m47812/Custom-3D-Printer-Controller/3D_Printer_Mainboard_STM32/Komponenten_V2.xlsx

Qty | Reference | VALUE | MF | DESCRIPTION | Dist. | Order Nr. | Price | Total
1 | NHD-0420AZ-FSW-GBW-33V3 |  |  | LCD Display 3.3V 20x4 | Mouser | 763-0420AZFSWGBW33V3 | 20
1 | ATWINC1500-MR210PB1954 |  |  | Wlan Modul | Mouser | 579-1500MR210PB1954 | 7.62
 | O705012MHEA4SI |  |  | Oszilatzor 12MHz | LCSC | C70647
 | HUF76639S3ST |  |  | Heatbed N MOS | LCSC | C184262 (https://lcsc.com/product-detail/MOSFET_ON-Semicon_HUF76639S3ST_ON-Semicon-ON-HUF76639S3ST_C184262.html/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)
2 | AO3400A |  |  | Extruder N MOS | LCSC | C20917 (https://lcsc.com/product-detail/MOSFET_Changjiang-Electronics-Tech-CJ-2N7002_C8545.html/?href=jlc-SMT)
 | 2920L260/24DR |  |  | Extruder Heater PTC Fuse 2.6A/24V | LCSC | C315904 (https://lcsc.com/product-detail/PTC-Resettable-Fuses_Littelfuse-2920L260-24DR_C315904.html/?href=jlc-SMT)
 | ATMEGA328P-AU |  |  | 328p atmega temperatur controller |  | C14877 (https://lcsc.com/product-detail/ATMEL-AVR_ATMEL_ATMEGA328P-AU_ATMEGA328P-AU_C14877.html/?href=jlc-SMT)
 | EL357N(C)(TA)-G |  |  | Optokopler Power ON |  | C29981 (https://lcsc.com/product-detail/SMD-Optocouplers_EL357N-C-TA-G_C29981.html/?href=jlc-SMT)
 |  |  |  | ELKO 220uF |  | C134732 (https://lcsc.com/product-detail/Aluminum-Electrolytic-Capacitors-SMD_Lelon-VE-221M1HTR-1010_C134732.html/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)
 |  |  |  | 3er Screw Terminal 2.54 6A |  | 651-1725669
 |  |  |  | 4er Screw Terminal 2.54 6A Stepper |  | 651-1725672
 |  |  |  | Spule 6.8uH MWSA0618-6R8MT |  | C132134 (https://lcsc.com/product-detail/Power-Inductors_Sunlord-MWSA0618-6R8MT_C132134.html/?href=jlc-SMT)
 |  |  |  | Header 2x3 2.54 dimensionen Prüfen |  | 649-1012938190602BLF
 |  |  |  | Header 2x8 2.54 dimensionen Prüfen |  | 855-M20-9720846
 |  |  |  | USB Stecker |  | 710-629105150521
 |  |  |  | 2er Screw Terminal 9.52mm 32A |  | 651-1756993
 |  |  |  | Heatbed Connector |  | 651-1888807
 |  |  |  | SD Karten Halter |  | 798-DM3D-SF
 |  |  |  | 100mohm widerstände |  | C63324
 |  |  |  | 100mOhm alternative |  | 71-RCWE1210R100FKEA
 |  |  |  | 22kOhm Poti |  | 652-3296Y-1-223LF
 |  |  |  | Switch |  | C318888 (https://lcsc.com/product-detail/Tactile-Switches_XKB-Enterprise-TS-1187A-C-D-A_C318888.html/?href=jlc-SMT)
 | STM32F722RET6 |  |  | Cortex-M7 mit FPU und DMA 64Pin |  | C118207 (https://lcsc.com/product-detail/ST-Microelectronics_STMicroelectronics_STM32F722RET6_STM32F722RET6_C118207.html/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)
 | TMC2209 |  |  | New smaler Motor driver |  | C465949 (https://lcsc.com/product-detail/Motor-Drivers_TRINAMIC-Motion-Control-GmbH-TMC2209-LA_C465949.html/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)
 | SMAZ27-13-F |  |  | Lüfterschutzdiode |  | C155318 (https://lcsc.com/product-detail/Zener-Diodes_DIODES_SMAZ27-13-F_SMAZ27-13-F_C155318.html/?href=jlc-SMT)
 | 100uF
 | 220uf |  |  |  |  | C164065 (https://lcsc.com/product-detail/Aluminum-Electrolytic-Capacitors-SMD_Lelon-VEJ221M1VTR-0810_C164065.html/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)
 |  |  |  | Screw Terminal 6Pin |  | 651-1725698
 | B5819W |  |  | Diode Stall E1 E0 |  | C8598 (https://lcsc.com/product-detail/Schottky-Barrier-Diodes-SBD_Changjiang-Electronics-Tech-CJ-B5819W_C8598.html/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)
 |  |  |  | LED MUPI |  | 78-TLLG4400-AS12
 |  |  |  | Button Mupi |  | C318887 (https://lcsc.com/product-detail/Tactile-Switches_XKB-Enterprise-TS-1187A-C-E-A_C318887.html/?href=jlc-SMT)
 |  |  |  | Ersatz MOS Heatbead |  | C180966 (https://lcsc.com/product-detail/MOSFET_Shenzhen-ruichips-Semicon-RU30120S_C180966.html/?href=jlc-SMT)
 |  |  |  | Ersatz Induktor 6.8uH |  | C408348
 | 220uf |  |  | Ersatz elko |  | C134820
