m47812/Custom-3D-Printer-Controller/3D_Printer_Mainboard_STM32/3D_Printer_Mainboard_STM32.pdf

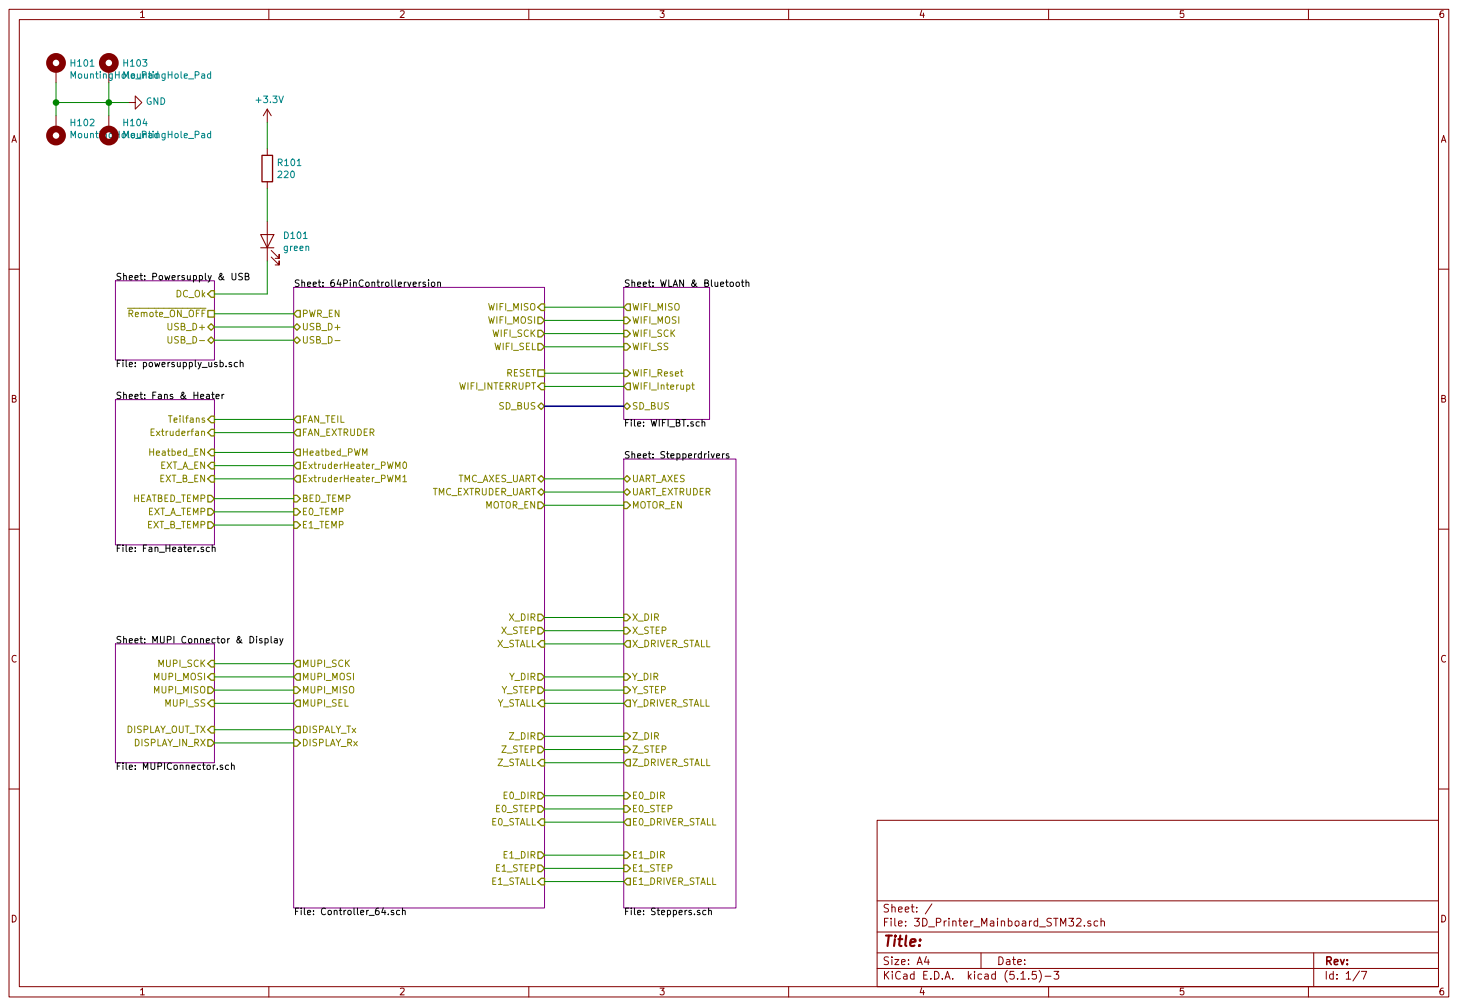
[picture p5: page 1]

Sheet: WLAN & Bluetooth File: WIFI_BT.sch WIFI_SS WIFI_MISO WIFI_SCK WIFI_Reset WIFI_Interupt WIFI_MOSI SD_BUS

Sheet: Fans & Heater File: Fan_Heater.sch Teilfans Extruderfan Heatbed_EN

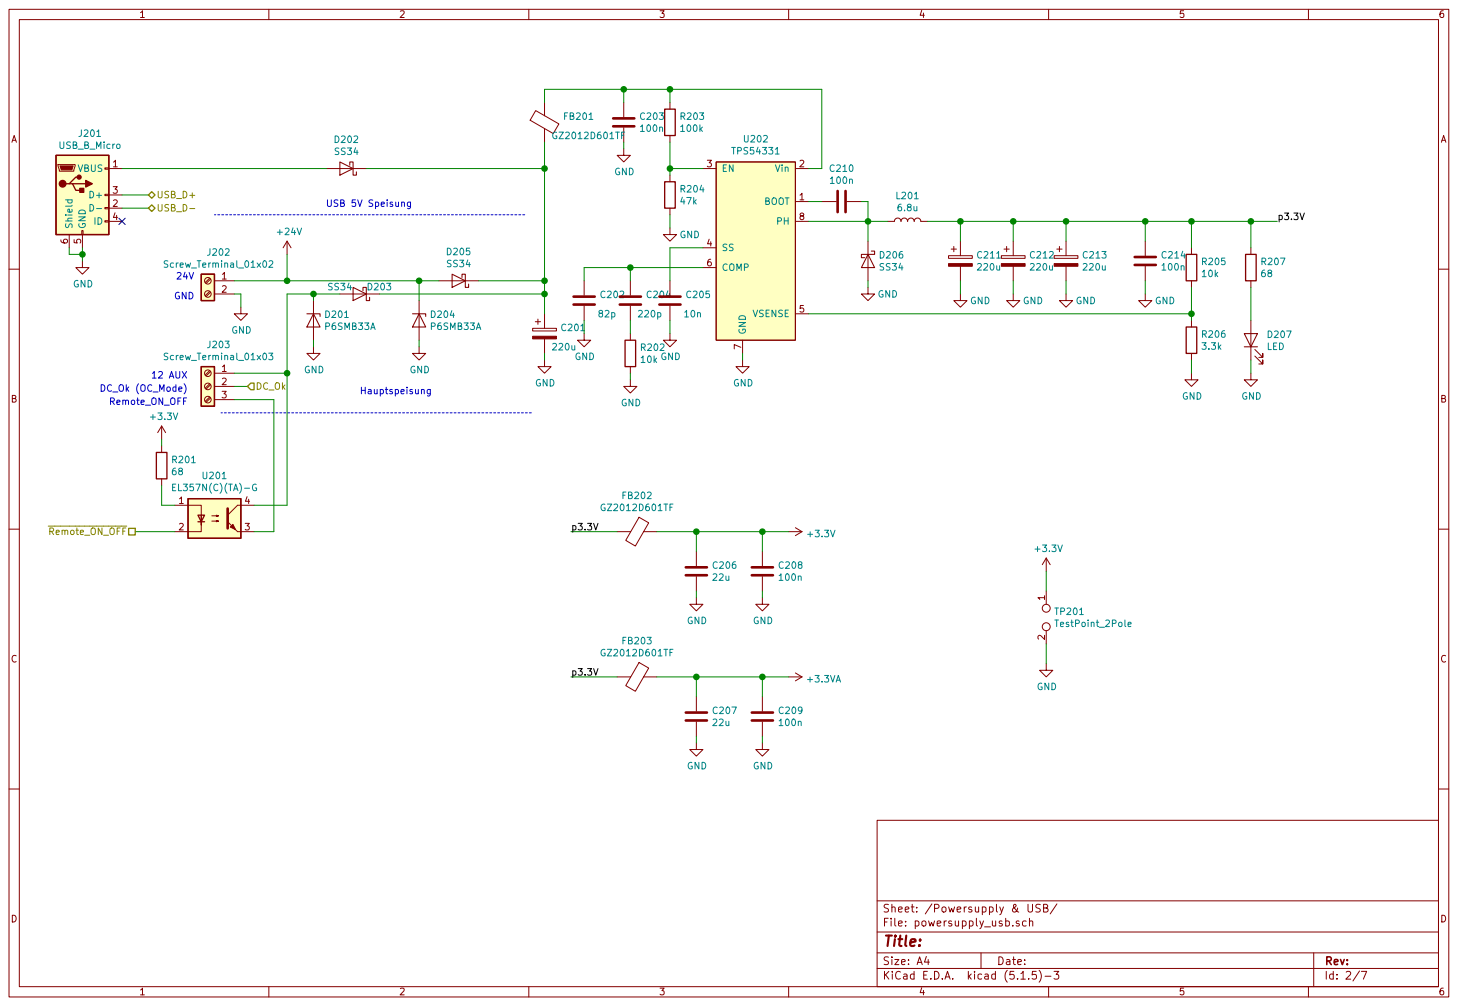
[picture p6: page 2]

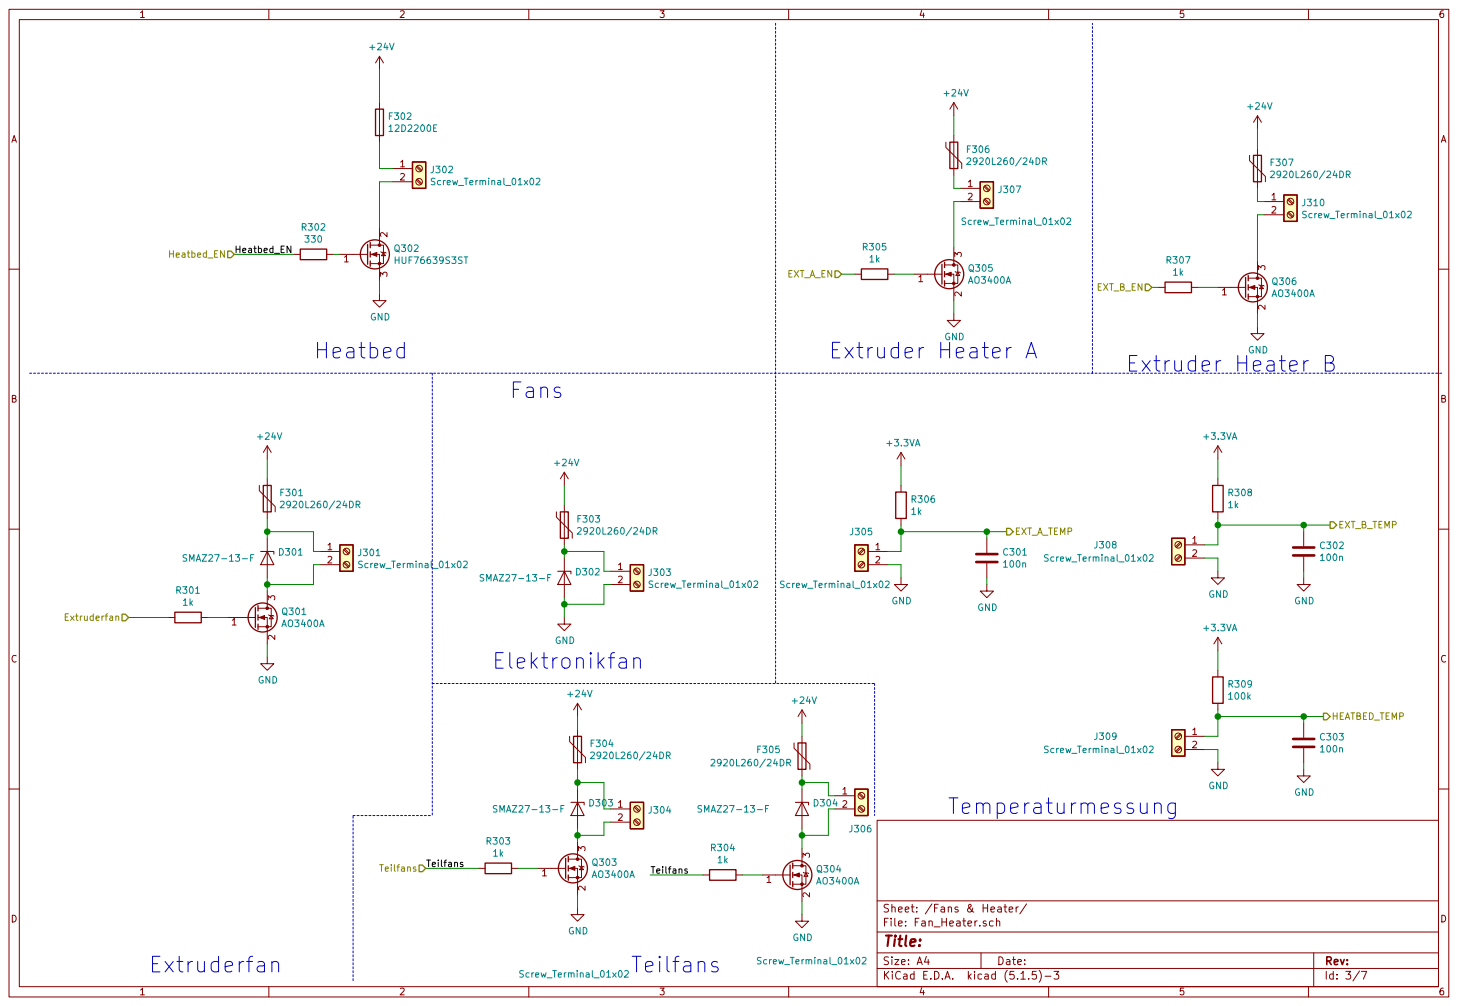
[picture p7: page 3]

File: Fan_Heater.sch Sheet: /Fans & Heater/
Id: 3/7 Title:

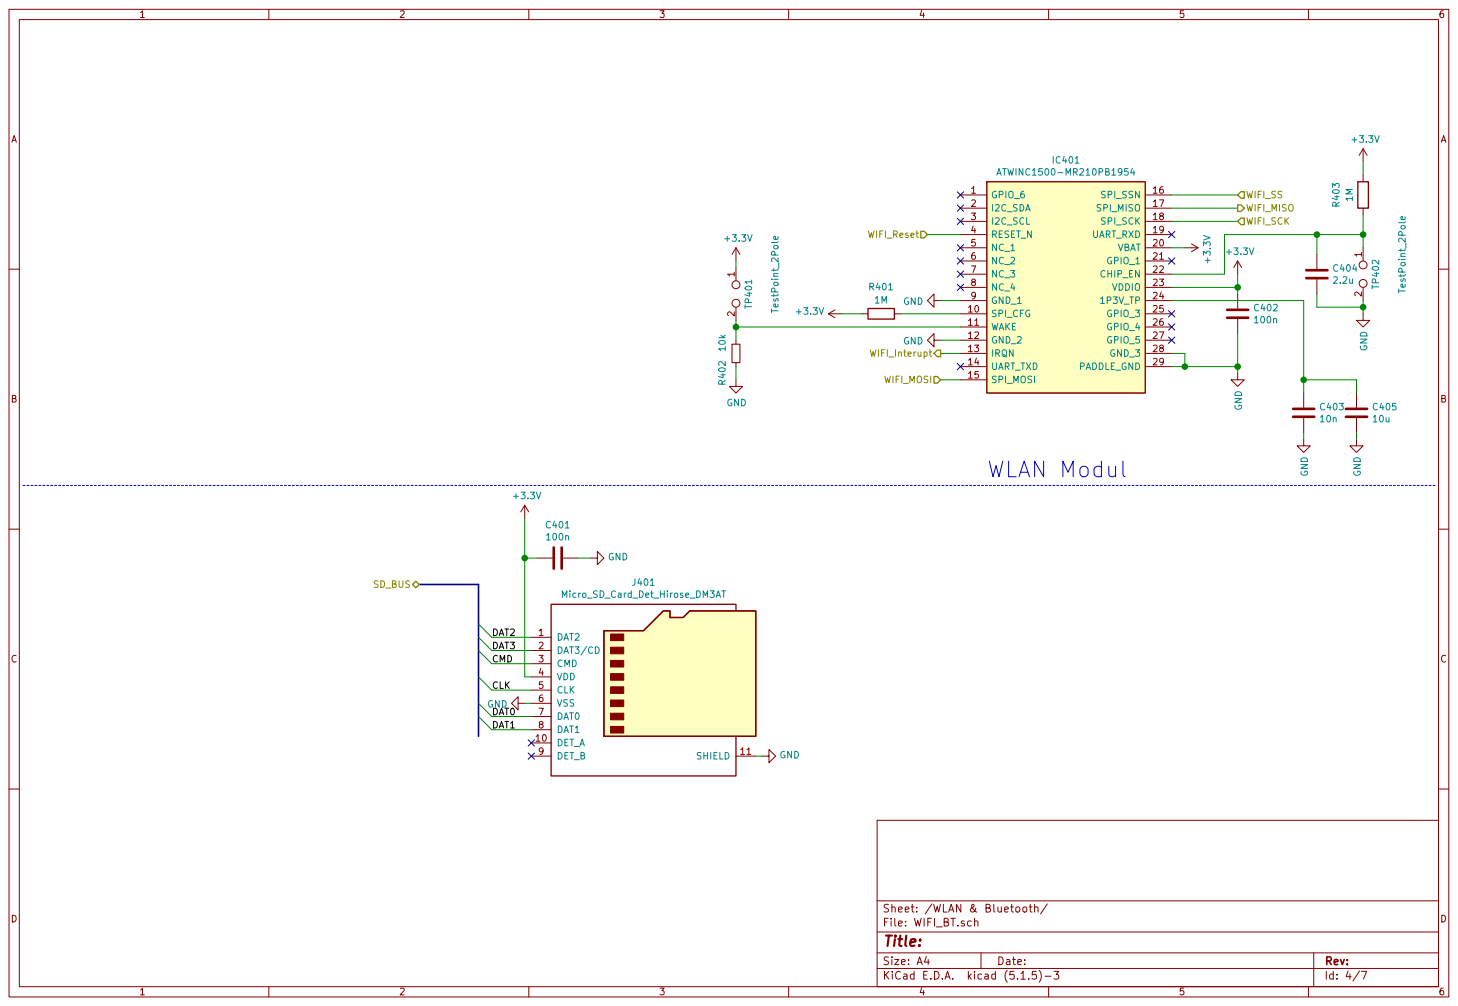
[picture p8: page 4]

1 2 TP401 TestPoint_2Pole DAT2 1 DET_A 10 SHIELD 11 DAT3/CD 2 CMD 3 VDD 4 CLK 5 VSS 6 DAT0 7 DAT1 8 DET_B 9

File: WIFI_BT.sch Sheet: /WLAN & Bluetooth/
Id: 4/7 Title:

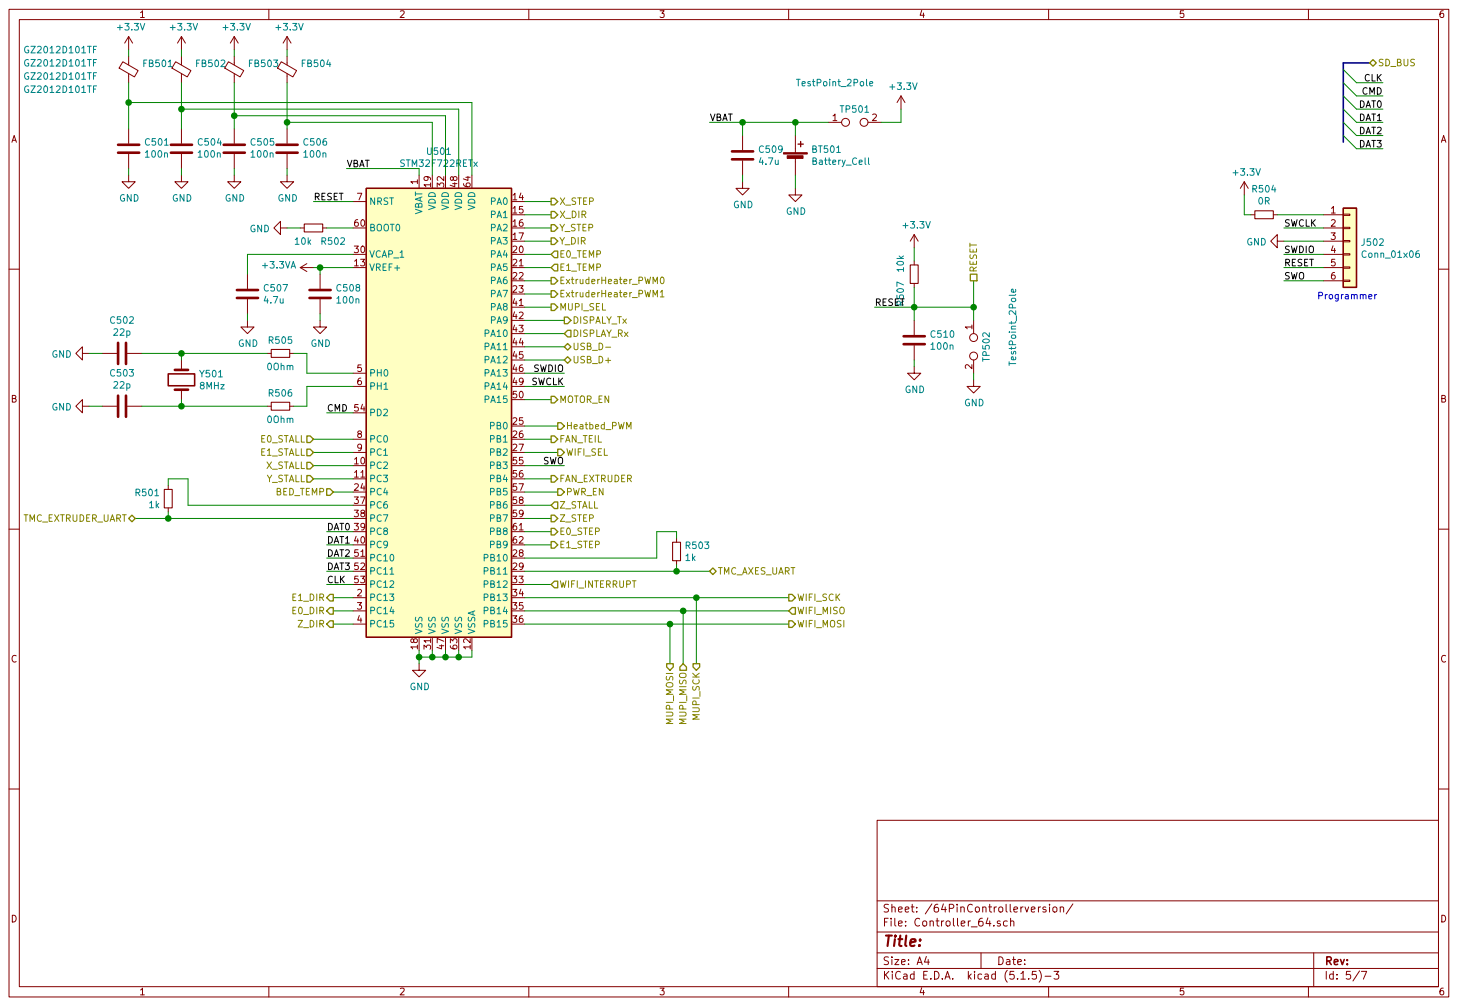
[picture p9: page 5]

1 VCAP_1 30 VDD 19 VDD 32 VDD 48 VDD 64 VREF+ 13 VSS 18 VSS 31 VSS 47 VSS 63 VSSA 12 U501 STM32F722RETx R504

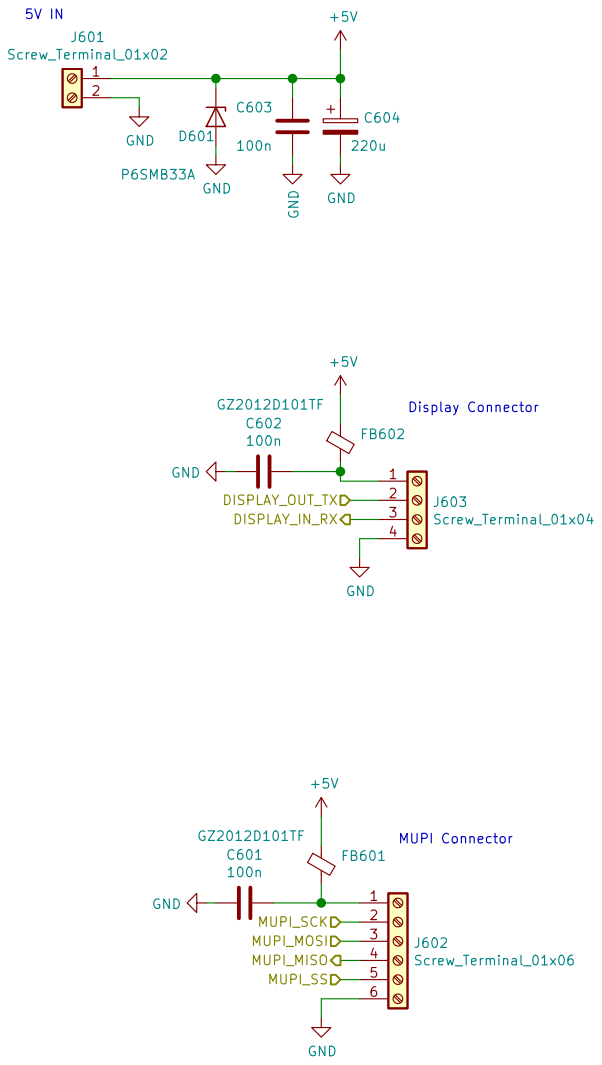
[picture p10: page 6]

Id: 6/7 Title: File: MUPIConnector.sch Sheet: /MUPI Connector & Display/ GND
J603 Screw_Terminal_01x04 GND

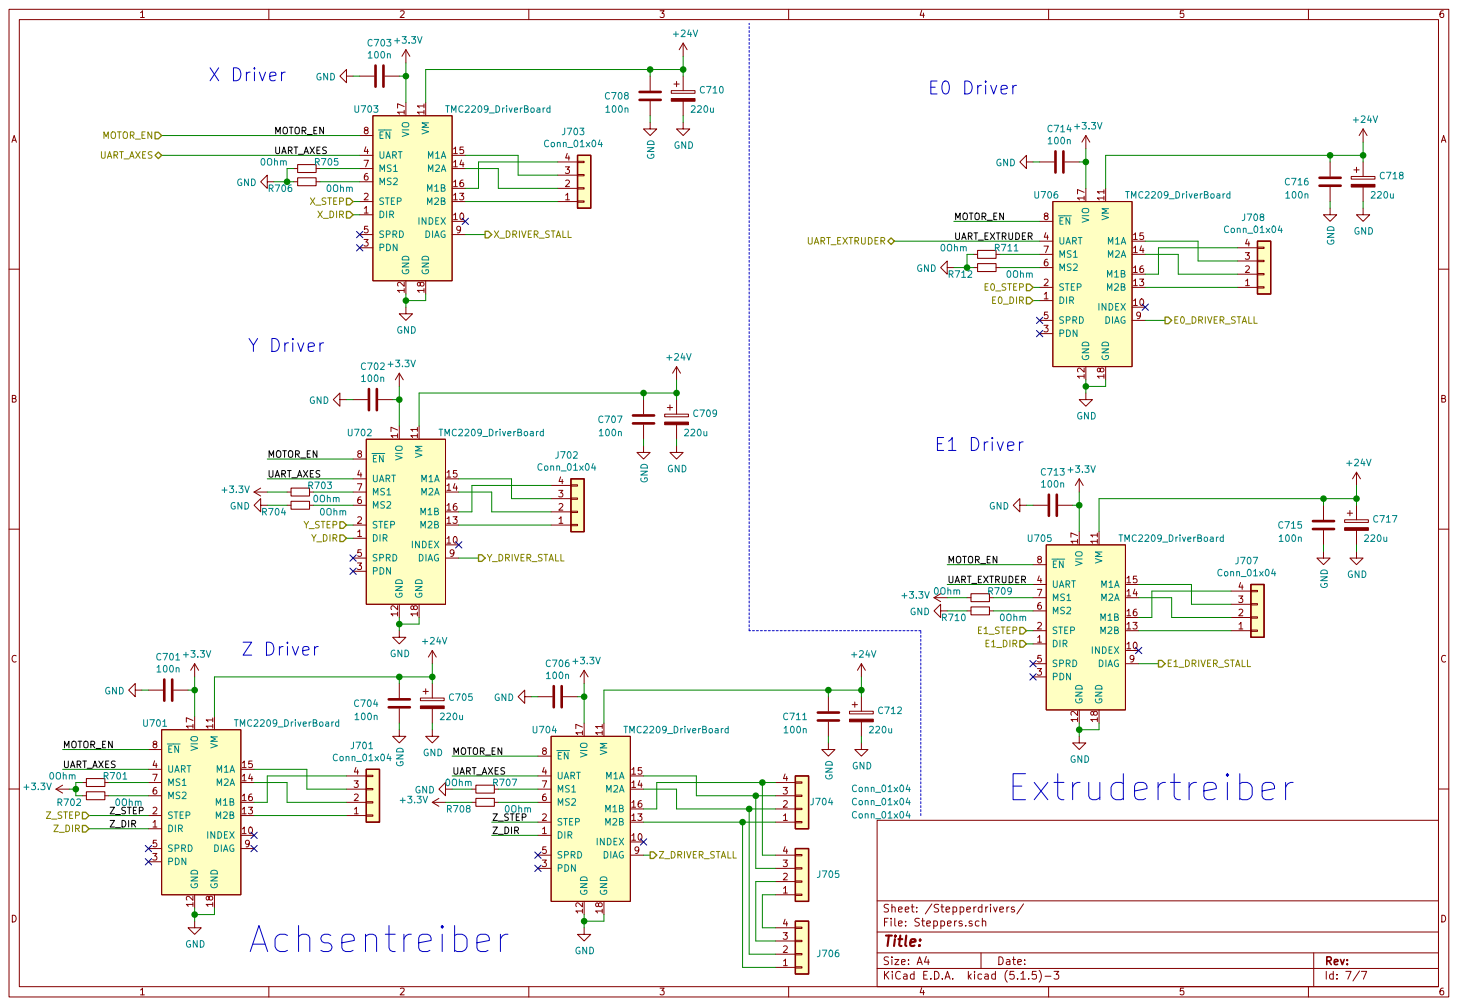
[picture p11: page 7]

3 | 0Ohm R707
