m47812/Custom-3D-Printer-Controller/3D_Printer_Handheld/Mupi.pdf

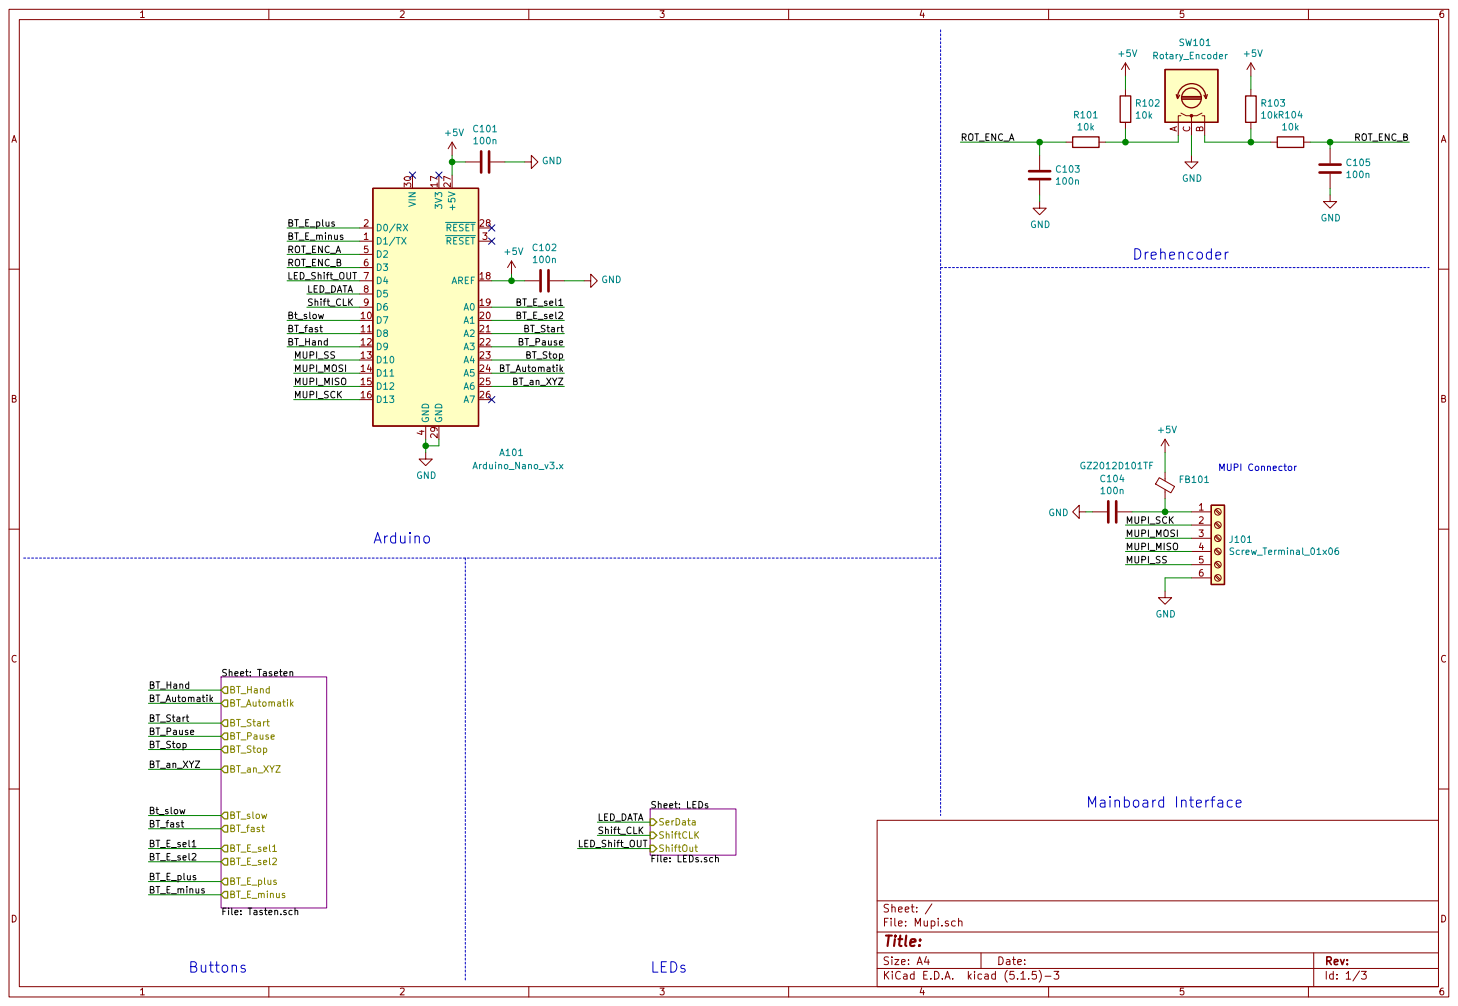
[picture p12: page 1]

File: Mupi.sch Sheet: / Sheet: Taseten File: Tasten.sch BT_Hand BT_Automatik BT_Start BT_Pause BT_Stop BT_slow

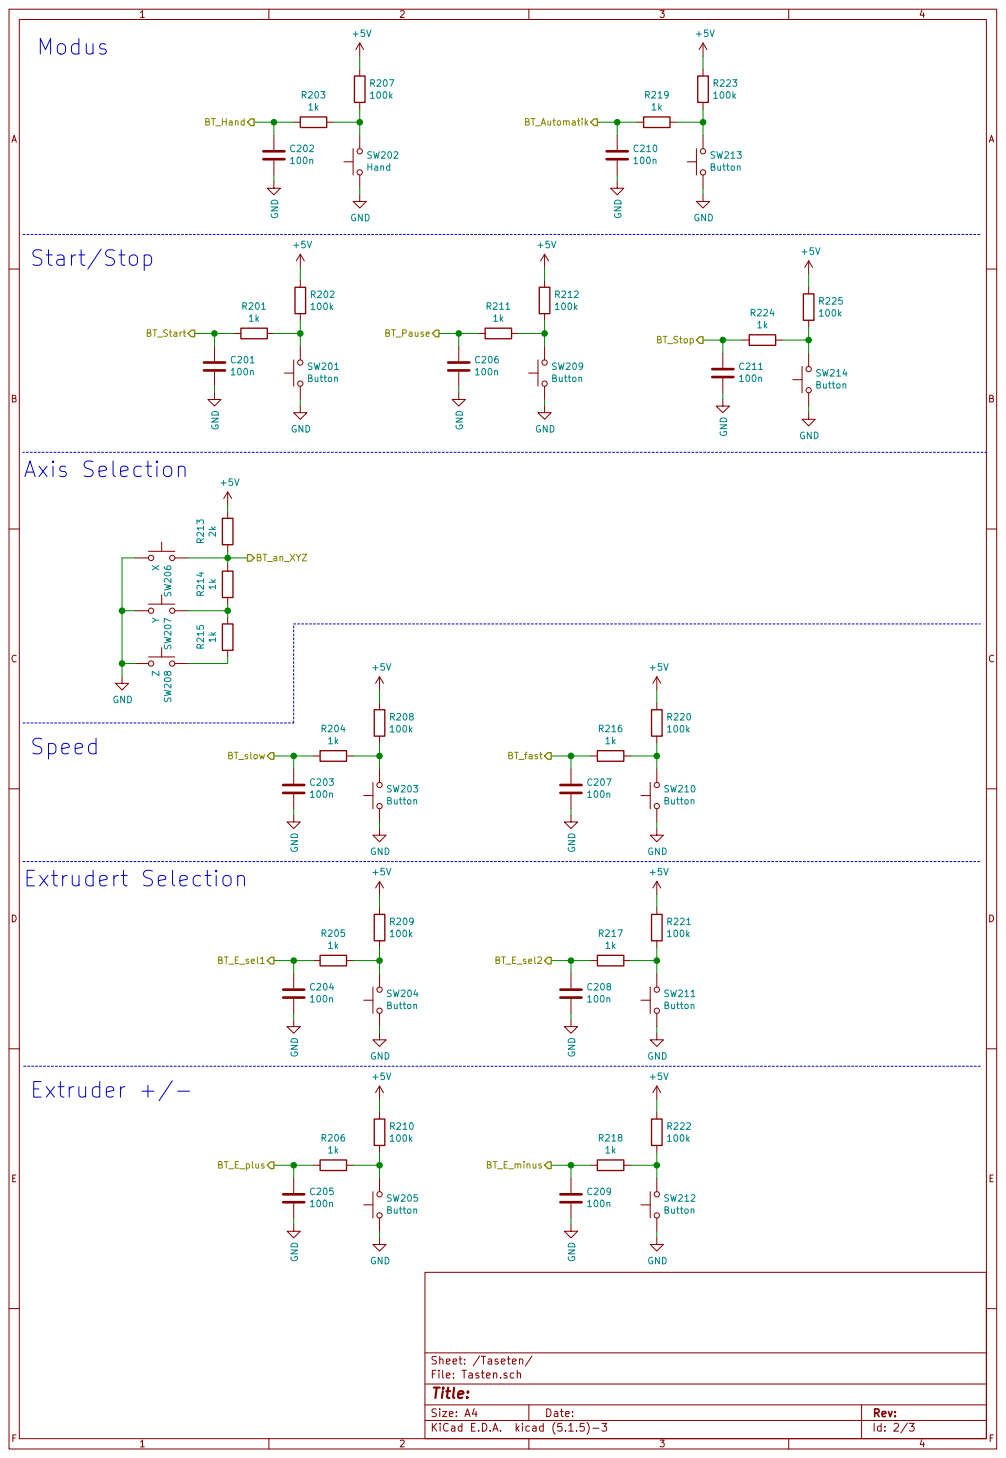
[picture p13: page 2]

Id: 2/3 Title: File: Tasten.sch Sheet: /Taseten/

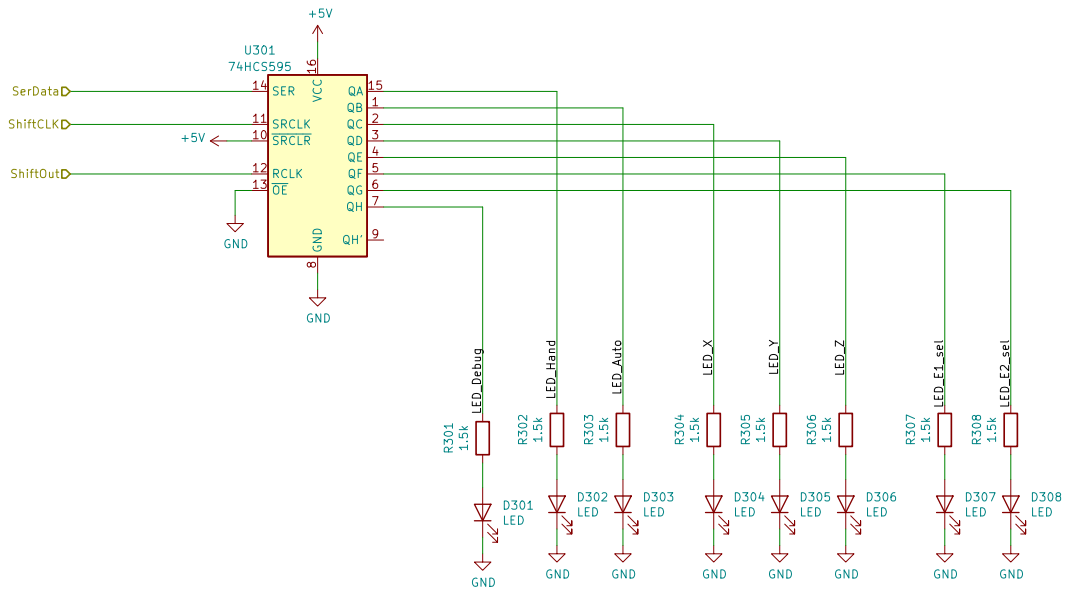
[picture p14: page 3]
