m47812/Custom-3D-Printer-Controller/3D_Printer_Handheld/Mupi_Board.pdf

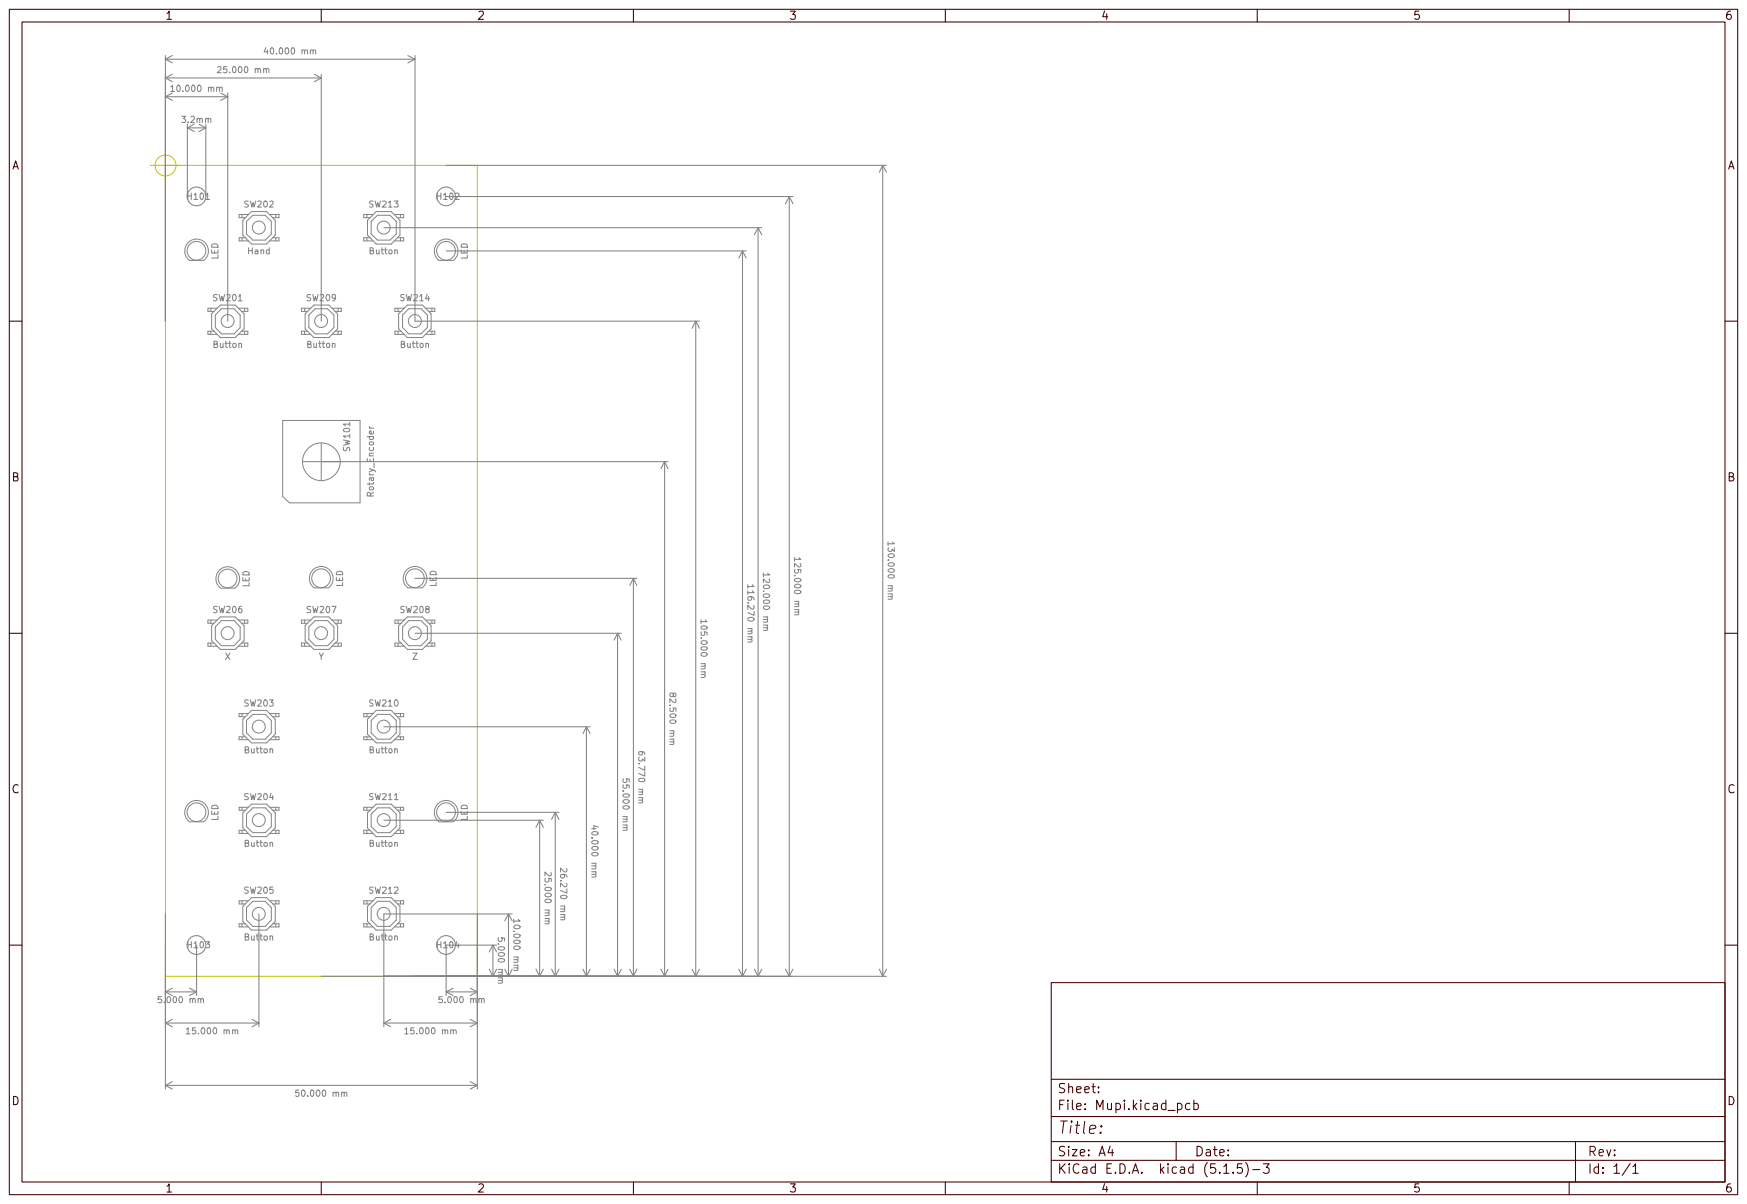
[picture p15: page 1]
