m47812/Custom-3D-Printer-Controller/3D_Printer_Handheld/Mupi.kicad_pcb

## KiCad design 3D_Printer_Handheld/Mupi.kicad_pcb (2022-04-30)

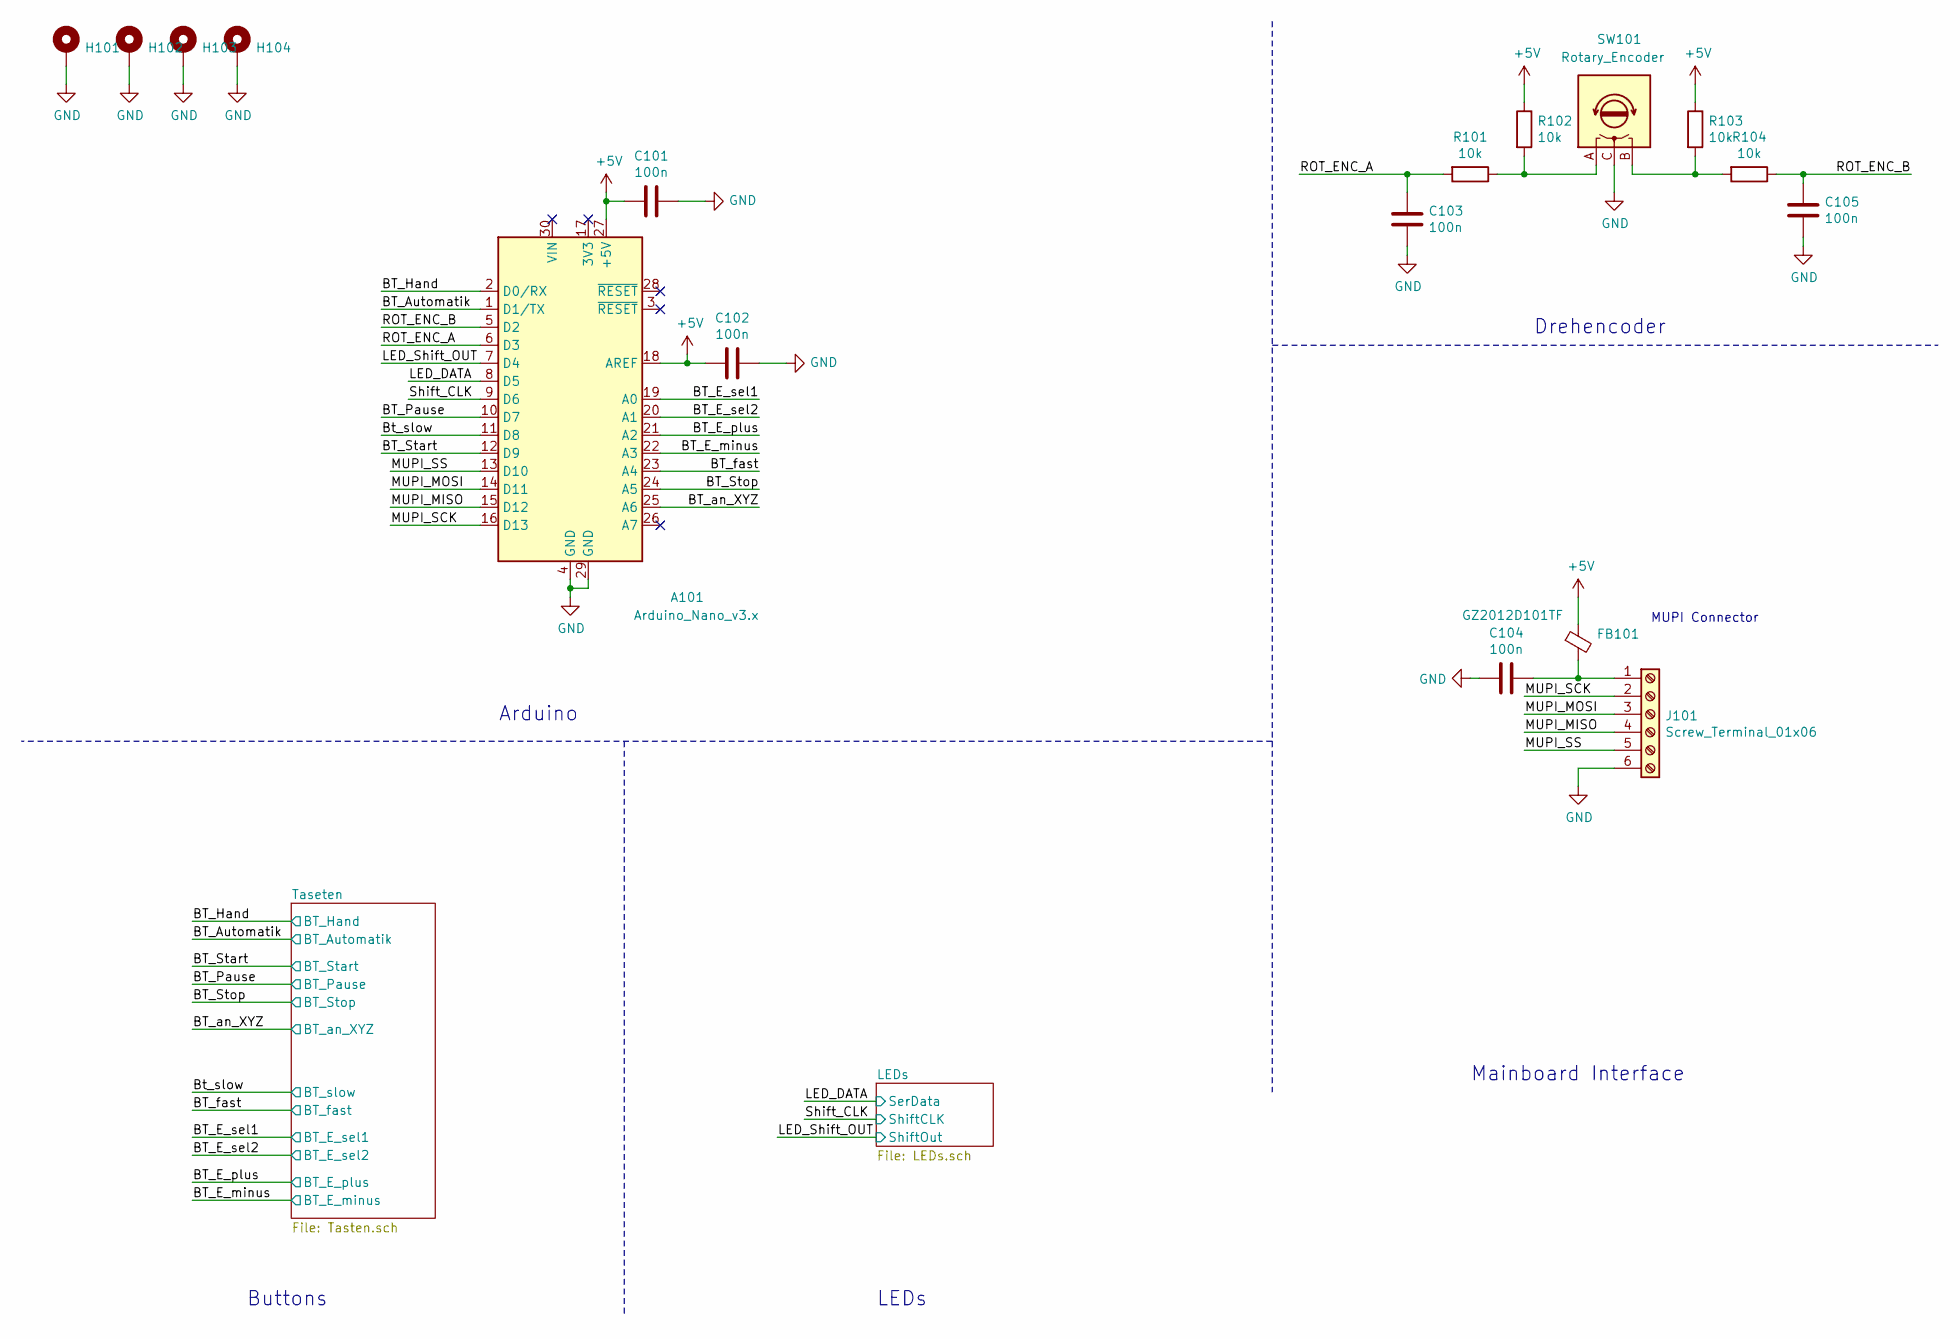
[picture p16: schematic Mupi.sch]

Parts:
A101: Arduino_Nano_v3.x; Arduino_Nano
C101, C102, C103, C104, C105: 100n; C_0805_2012Metric_Pad1.15x1.40mm_HandSolder
FB101: GZ2012D101TF; R_0805_2012Metric
H101, H102, H103, H104: MountingHole_Pad; MountingHole_3.2mm_M3_Pad_Via
J101: Screw_Terminal_01x06; TerminalBlock_Phoenix_MPT-0,5-6-2.54_1x06_P2.54mm_Horizontal
R101, R102, R103, R104: 10k; R_0805_2012Metric_Pad1.15x1.40mm_HandSolder
SW101: Rotary_Encoder; RotaryEncoder_Alps_EC12E_Vertical_H20mm

Connections:
+5V: A101.18 (AREF), A101.27 (+5V), C101.2, C102.2, FB101.1, R102.1, R103.1; also elsewhere on the board
/BT_Automatik: A101.1 (D1/TX); also elsewhere on the board
/BT_E_minus: A101.22 (A3); also elsewhere on the board
/BT_E_plus: A101.21 (A2); also elsewhere on the board
/BT_E_sel1: A101.19 (A0); also elsewhere on the board
/BT_E_sel2: A101.20 (A1); also elsewhere on the board
/BT_Hand: A101.2 (D0/RX); also elsewhere on the board
/BT_Pause: A101.10 (D7); also elsewhere on the board
/BT_Start: A101.12 (D9); also elsewhere on the board
/BT_Stop: A101.24 (A5); also elsewhere on the board
/BT_an_XYZ: A101.25 (A6); also elsewhere on the board
/BT_fast: A101.23 (A4); also elsewhere on the board
/Bt_slow: A101.11 (D8); also elsewhere on the board
/LED_DATA: A101.8 (D5); also elsewhere on the board
/LED_Shift_OUT: A101.7 (D4); also elsewhere on the board
/MUPI_MISO: A101.15 (D12), J101.4
/MUPI_MOSI: A101.14 (D11), J101.3
/MUPI_SCK: A101.16 (D13), J101.2
/MUPI_SS: A101.13 (D10), J101.5
/Shift_CLK: A101.9 (D6); also elsewhere on the board
GND: A101.4 (GND), A101.29 (GND), C101.1, C102.1, C103.2, C104.2, C105.2, H101.1, H102.1, H103.1, H104.1, J101.6, SW101.C; also elsewhere on the board
unnamed: C104.1, FB101.2, J101.1
unnamed: R101.1, R102.2, SW101.A
unnamed: R103.2, R104.2, SW101.B

Notes on the sheet:
Drehencoder
MUPI Connector
Mainboard Interface
Buttons
LEDs
Arduino

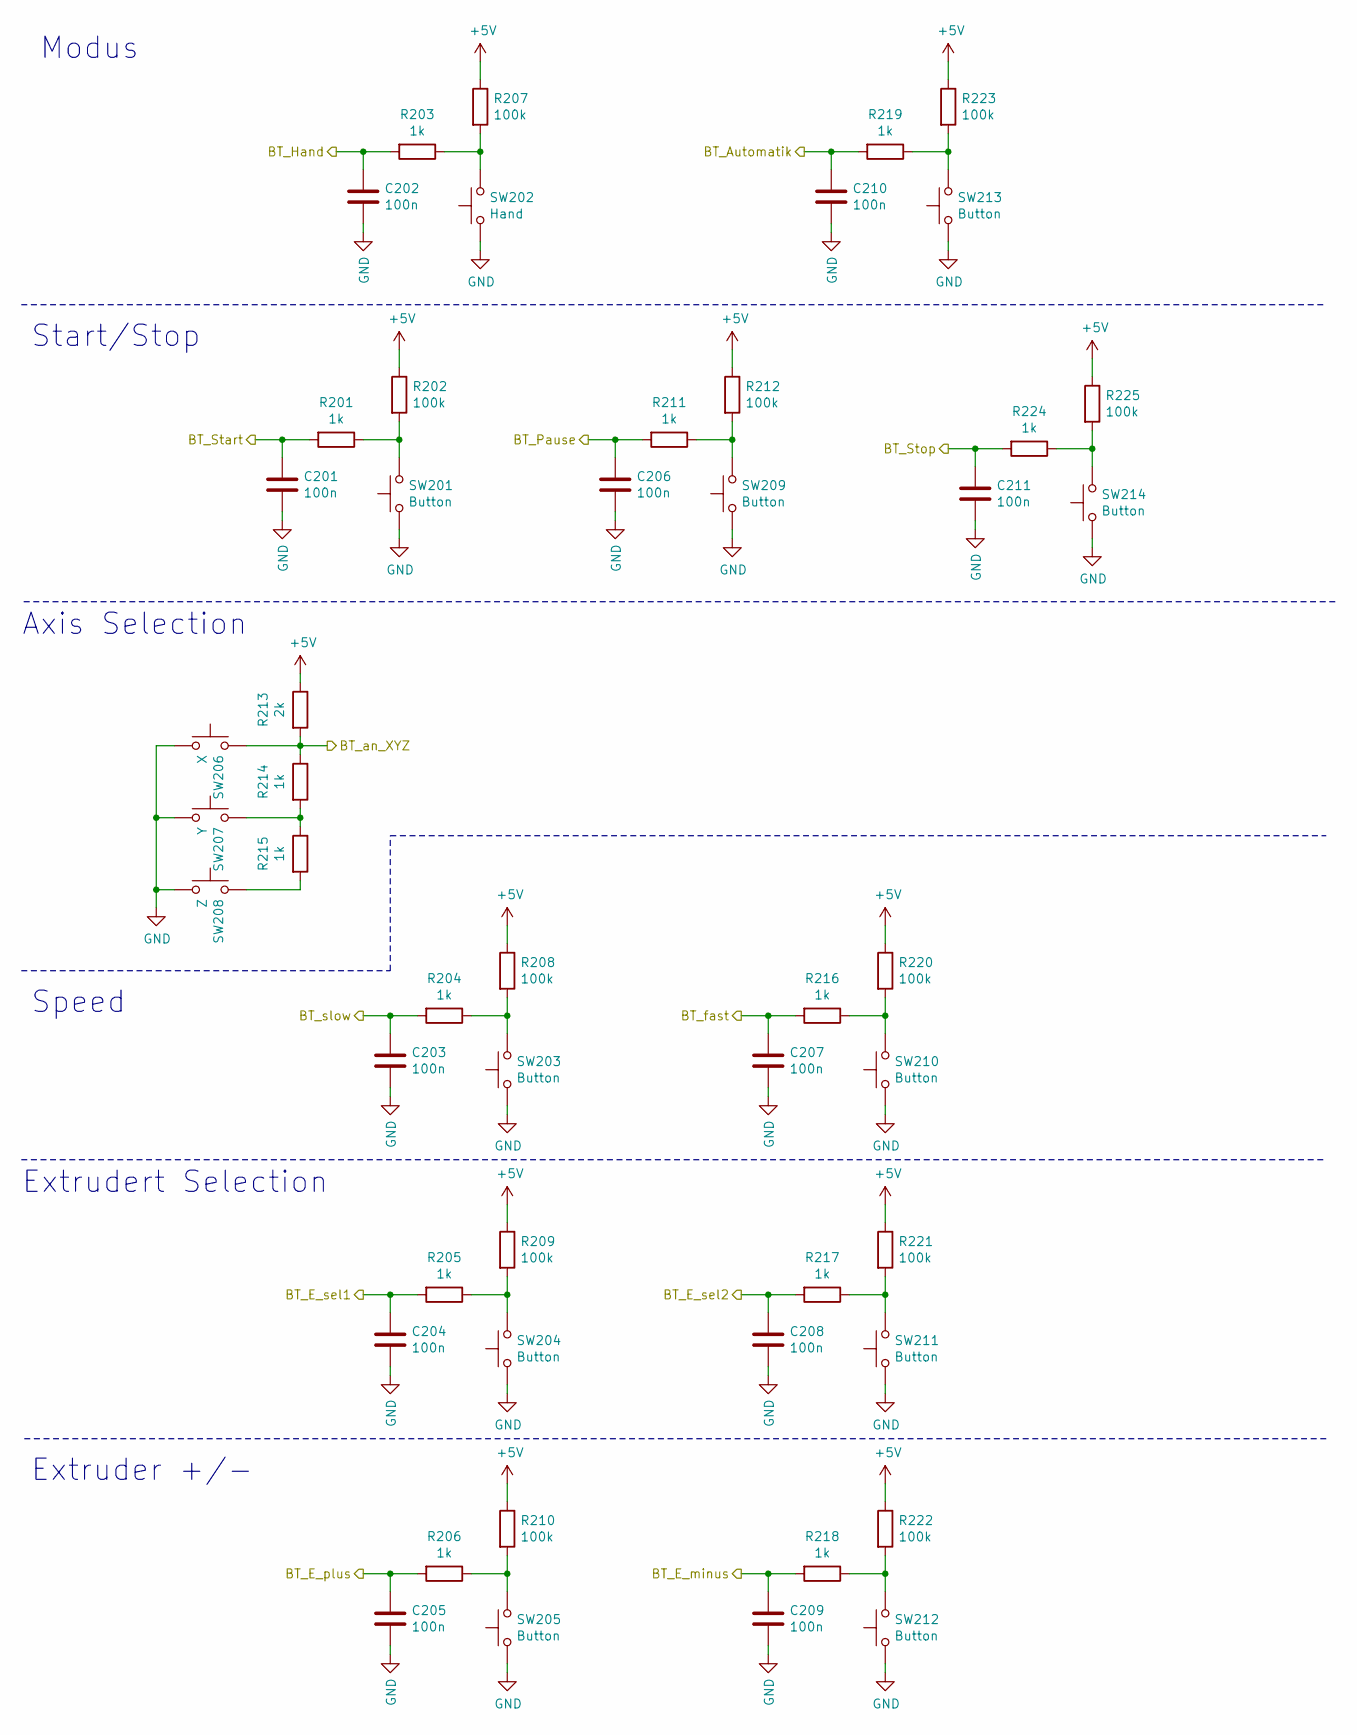
[picture p17: schematic Tasten.sch]

Parts:
C201, C202, C203, C204, C205, C206, C207, C208, C209, C210, C211: 100n; C_0805_2012Metric_Pad1.15x1.40mm_HandSolder
R201, R203, R204, R205, R206, R211, R214, R215, R216, R217, R218, R219, R224: 1k; R_0805_2012Metric_Pad1.15x1.40mm_HandSolder
R202, R207, R208, R209, R210, R212, R220, R221, R222, R223, R225: 100k; R_0805_2012Metric_Pad1.15x1.40mm_HandSolder
R213: 2k; R_0805_2012Metric_Pad1.15x1.40mm_HandSolder
SW201, SW203, SW204, SW205, SW209, SW210, SW211, SW212, SW213, SW214: Button; SW_SPST_TL3342
SW202: Hand; SW_SPST_TL3342
SW206: X; SW_SPST_TL3342
SW207: Y; SW_SPST_TL3342
SW208: Z; SW_SPST_TL3342

Connections:
+5V: R202.1, R207.1, R208.1, R209.1, R210.1, R212.1, R213.1, R220.1, R221.1, R222.1, R223.1, R225.1; also elsewhere on the board
/BT_Automatik: C210.2, R219.2; also elsewhere on the board
/BT_E_minus: C209.2, R218.2; also elsewhere on the board
/BT_E_plus: C205.2, R206.2; also elsewhere on the board
/BT_E_sel1: C204.2, R205.2; also elsewhere on the board
/BT_E_sel2: C208.2, R217.2; also elsewhere on the board
/BT_Hand: C202.2, R203.2; also elsewhere on the board
/BT_Pause: C206.2, R211.2; also elsewhere on the board
/BT_Start: C201.2, R201.2; also elsewhere on the board
/BT_Stop: C211.2, R224.2; also elsewhere on the board
/BT_an_XYZ: R213.2, R214.1, SW206.2; also elsewhere on the board
/BT_fast: C207.2, R216.2; also elsewhere on the board
/Bt_slow: C203.2, R204.2; also elsewhere on the board
GND: C201.1, C202.1, C203.1, C204.1, C205.1, C206.1, C207.1, C208.1, C209.1, C210.1, C211.1, SW201.1, SW202.1, SW203.1, SW204.1, SW205.1, SW206.1, SW207.1, SW208.1, SW209.1, SW210.1, SW211.1, SW212.1, SW213.1, SW214.1; also elsewhere on the board
unnamed: R201.1, R202.2, SW201.2
unnamed: R203.1, R207.2, SW202.2
unnamed: R204.1, R208.2, SW203.2
unnamed: R205.1, R209.2, SW204.2
unnamed: R206.1, R210.2, SW205.2
unnamed: R211.1, R212.2, SW209.2
unnamed: R214.2, R215.1, SW207.2
unnamed: R215.2, SW208.2
unnamed: R216.1, R220.2, SW210.2
unnamed: R217.1, R221.2, SW211.2
unnamed: R218.1, R222.2, SW212.2
unnamed: R219.1, R223.2, SW213.2
unnamed: R224.1, R225.2, SW214.2

Notes on the sheet:
Modus
Start/Stop
Axis Selection
Speed
Extrudert Selection
Extruder +/-

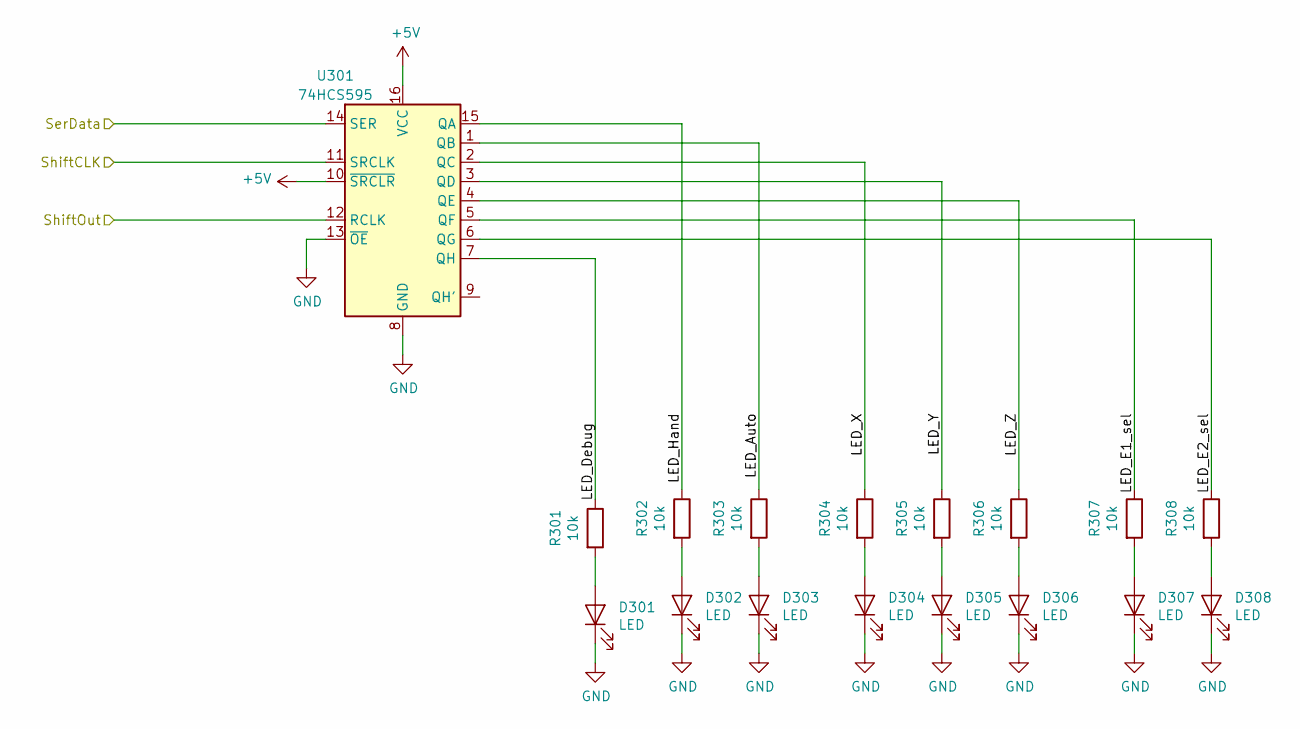
[picture p18: schematic LEDs.sch]

Parts:
D301: LED; LED_0603_1608Metric
D302, D303, D304, D305, D306, D307, D308: LED; LED_D3.0mm
R301, R302, R303, R304, R305, R306, R307, R308: 10k; R_0805_2012Metric_Pad1.15x1.40mm_HandSolder
U301: 74HCS595; SOIC-16_3.9x9.9mm_P1.27mm

Connections:
+5V: U301.10 (~SRCLR), U301.16 (VCC); also elsewhere on the board
/LED_DATA: U301.14 (SER); also elsewhere on the board
/LED_Shift_OUT: U301.12 (RCLK); also elsewhere on the board
/LEDs/LED_Auto: R303.1, U301.1 (QB)
/LEDs/LED_Debug: R301.1, U301.7 (QH)
/LEDs/LED_E1_sel: R307.1, U301.5 (QF)
/LEDs/LED_E2_sel: R308.1, U301.6 (QG)
/LEDs/LED_Hand: R302.1, U301.15 (QA)
/LEDs/LED_X: R304.1, U301.2 (QC)
/LEDs/LED_Y: R305.1, U301.3 (QD)
/LEDs/LED_Z: R306.1, U301.4 (QE)
/Shift_CLK: U301.11 (SRCLK); also elsewhere on the board
GND: D301.1 (K), D302.1 (K), D303.1 (K), D304.1 (K), D305.1 (K), D306.1 (K), D307.1 (K), D308.1 (K), U301.8 (GND), U301.13 (~OE); also elsewhere on the board
unnamed: D301.2 (A), R301.2
unnamed: D302.2 (A), R302.2
unnamed: D303.2 (A), R303.2
unnamed: D304.2 (A), R304.2
unnamed: D305.2 (A), R305.2
unnamed: D306.2 (A), R306.2
unnamed: D307.2 (A), R307.2
unnamed: D308.2 (A), R308.2

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
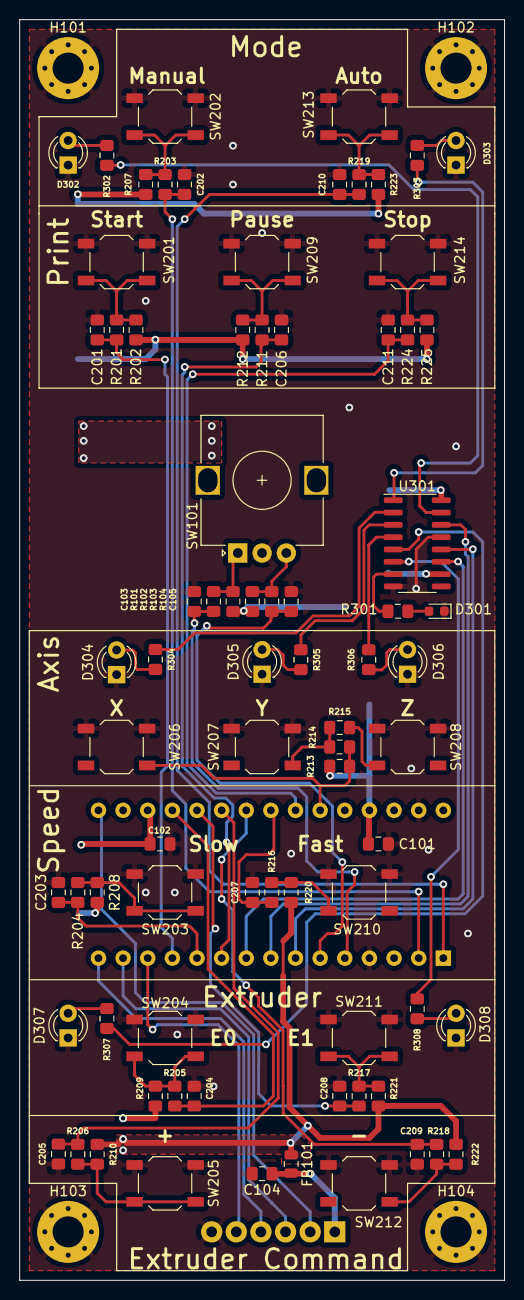
[picture p19: board Mupi.kicad_pcb from above]

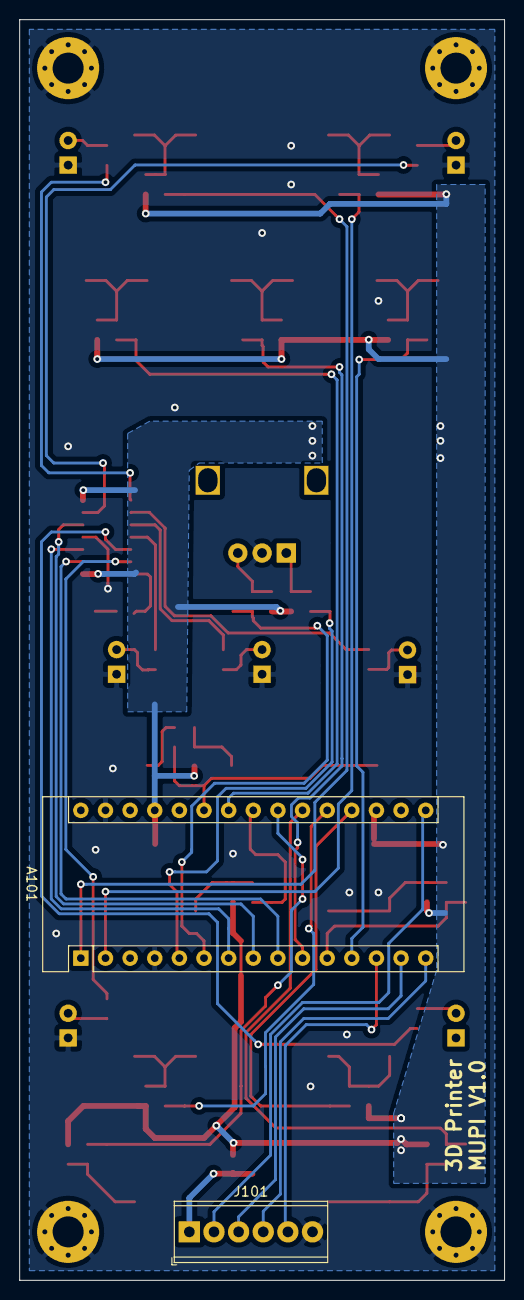
[picture p20: board Mupi.kicad_pcb from below]

Board: 2 copper layers, 50.0 x 130.0 mm, 84 parts (2 on the bottom side), 55 nets.
