m47812/Custom-3D-Printer-Controller/3D_Printer_Motor_Driver/3D_Printer_Stepper_TMC2209.kicad_pcb

## KiCad design 3D_Printer_Motor_Driver/3D_Printer_Stepper_TMC2209.kicad_pcb (2022-04-30)

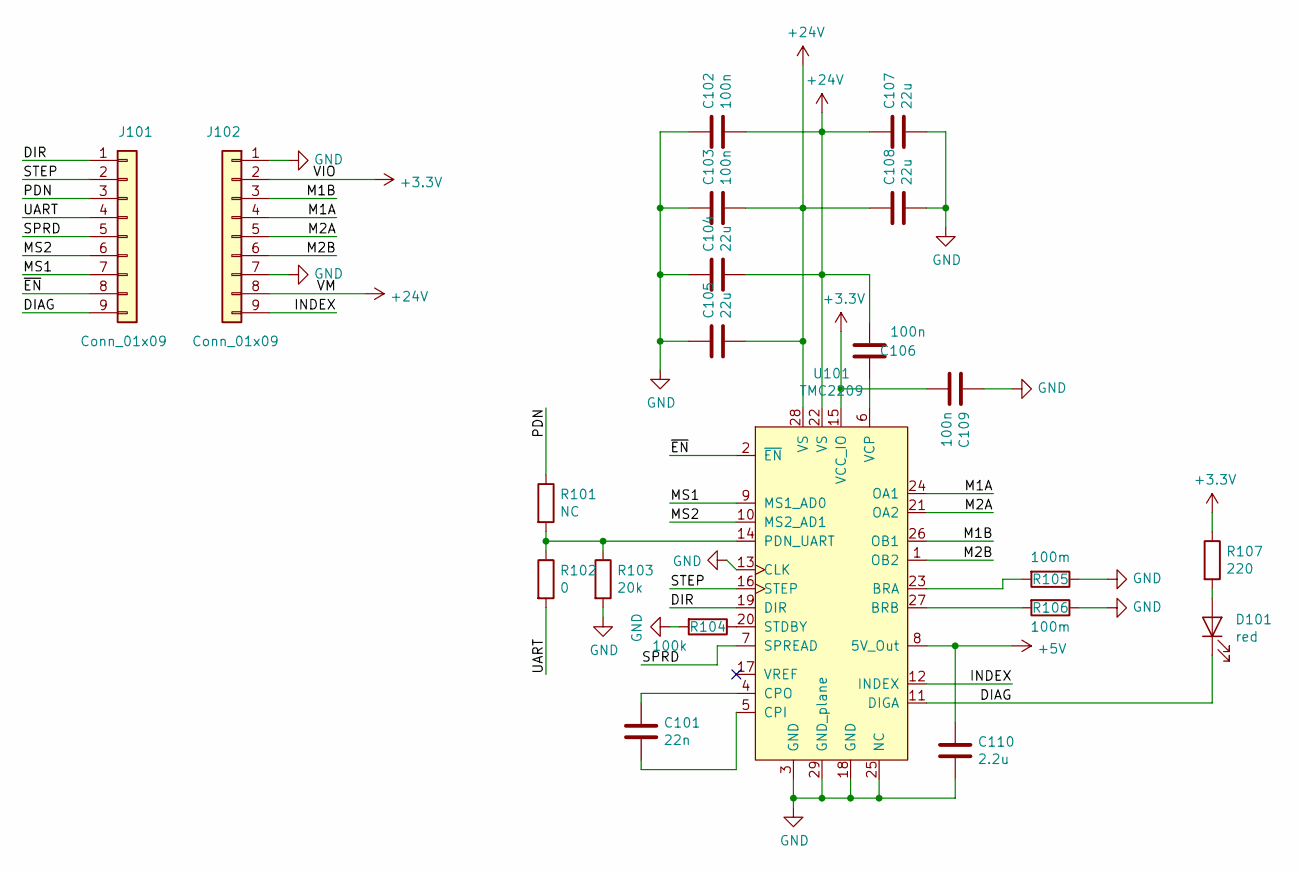
[picture p21: schematic 3D_Printer_Stepper_TMC2209.sch]

Parts:
C101: 22n; C_0805_2012Metric
C102, C103, C106, C109: 100n; C_0603_1608Metric
C104, C105, C107, C108: 22u; C_0805_2012Metric
C110: 2.2u; C_0603_1608Metric
D101: red; LED_0603_1608Metric
J101, J102: Conn_01x09; PinHeader_1x09_P2.54mm_Vertical
R101: NC; R_0603_1608Metric_Pad1.05x0.95mm_HandSolder
R102: 0; R_0603_1608Metric_Pad1.05x0.95mm_HandSolder
R103: 20k; R_0402_1005Metric
R104: 100k; R_0402_1005Metric
R105, R106: 100m; R_2512_6332Metric
R107: 220; R_0603_1608Metric
U101: TMC2209; QFN-28-1EP_5x5mm_P0.5mm_EP3.35x3.35mm_ThermalVias

Connections:
+3V3: C109.2, J102.2, R107.1, U101.15 (VCC_IO)
+5V: C110.1, U101.8 (5V_Out)
+24V: C102.2, C103.2, C104.2, C105.2, C106.2, C107.1, C108.1, J102.8, U101.22 (VS), U101.28 (VS)
/DIAG: D101.1 (K), J101.9, U101.11 (DIGA)
/DIR: J101.1, U101.19 (DIR)
/INDEX: J102.9, U101.12 (INDEX)
/M1A: J102.4, U101.24 (OA1)
/M1B: J102.3, U101.26 (OB1)
/M2A: J102.5, U101.21 (OA2)
/M2B: J102.6, U101.1 (OB2)
/MS1: J101.7, U101.9 (MS1_AD0)
/MS2: J101.6, U101.10 (MS2_AD1)
/PDN: J101.3, R101.1
/SPRD: J101.5, U101.7 (SPREAD)
/STEP: J101.2, U101.16 (STEP)
/UART: J101.4, R102.2
/~EN: J101.8, U101.2 (~EN)
GND: C102.1, C103.1, C104.1, C105.1, C107.2, C108.2, C109.1, C110.2, J102.1, J102.7, R103.2, R104.2, R105.1, R106.1, U101.3 (GND), U101.13 (CLK), U101.18 (GND), U101.25 (NC), U101.29 (GND_plane)
unnamed: C101.1, U101.4 (CPO)
unnamed: C101.2, U101.5 (CPI)
unnamed: C106.1, U101.6 (VCP)
unnamed: D101.2 (A), R107.2
unnamed: R101.2, R102.1, R103.1, U101.14 (PDN_UART)
unnamed: R104.1, U101.20 (STDBY)
unnamed: R105.2, U101.23 (BRA)
unnamed: R106.2, U101.27 (BRB)

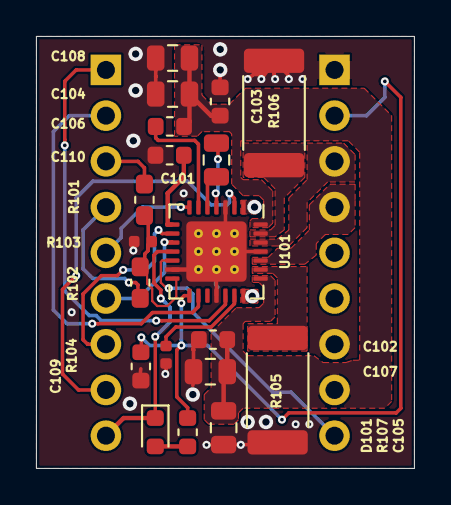
[picture p22: board 3D_Printer_Stepper_TMC2209.kicad_pcb from above]

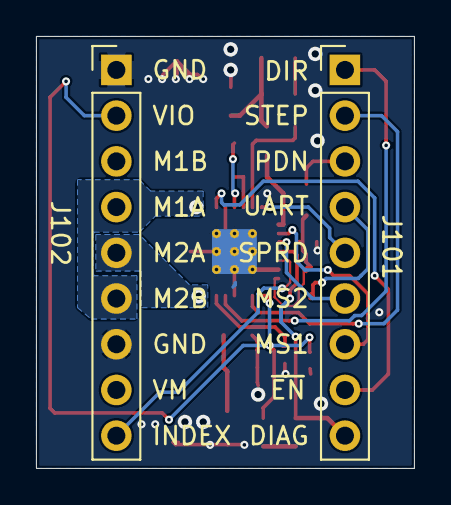
[picture p23: board 3D_Printer_Stepper_TMC2209.kicad_pcb from below]

Board: 2 copper layers, 21.0 x 24.0 mm, 21 parts (2 on the bottom side), 26 nets.
