m47812/Custom-3D-Printer-Controller/3D_Printer_Mainboard_STM32/3D_Printer_Mainboard_STM32.kicad_pcb

## KiCad design 3D_Printer_Mainboard_STM32/3D_Printer_Mainboard_STM32.kicad_pcb (2022-04-30)

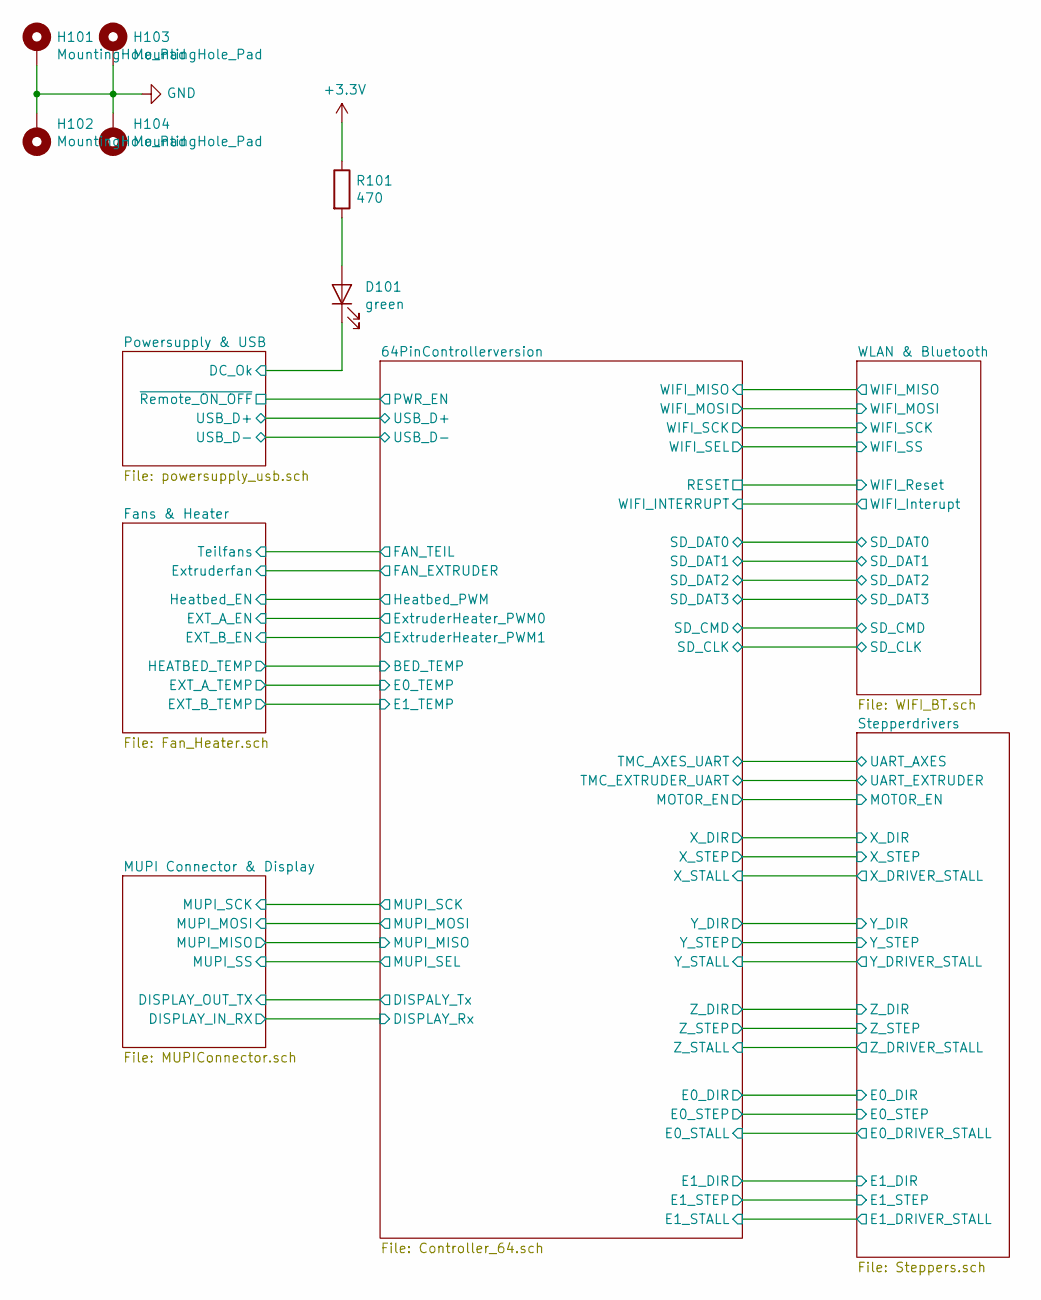
[picture p24: schematic 3D_Printer_Mainboard_STM32.sch]

Parts:
D101: green; LED_0603_1608Metric
H101, H102, H103, H104: MountingHole_Pad; MountingHole_4.3mm_M4_Pad_Via
R101: 470; R_0603_1608Metric

Connections:
+3V3: R101.1; also elsewhere on the board
/Powersupply & USB/DC_Ok: D101.1 (K); also elsewhere on the board
GND: H101.1, H102.1, H103.1, H104.1; also elsewhere on the board
unnamed: D101.2 (A), R101.2

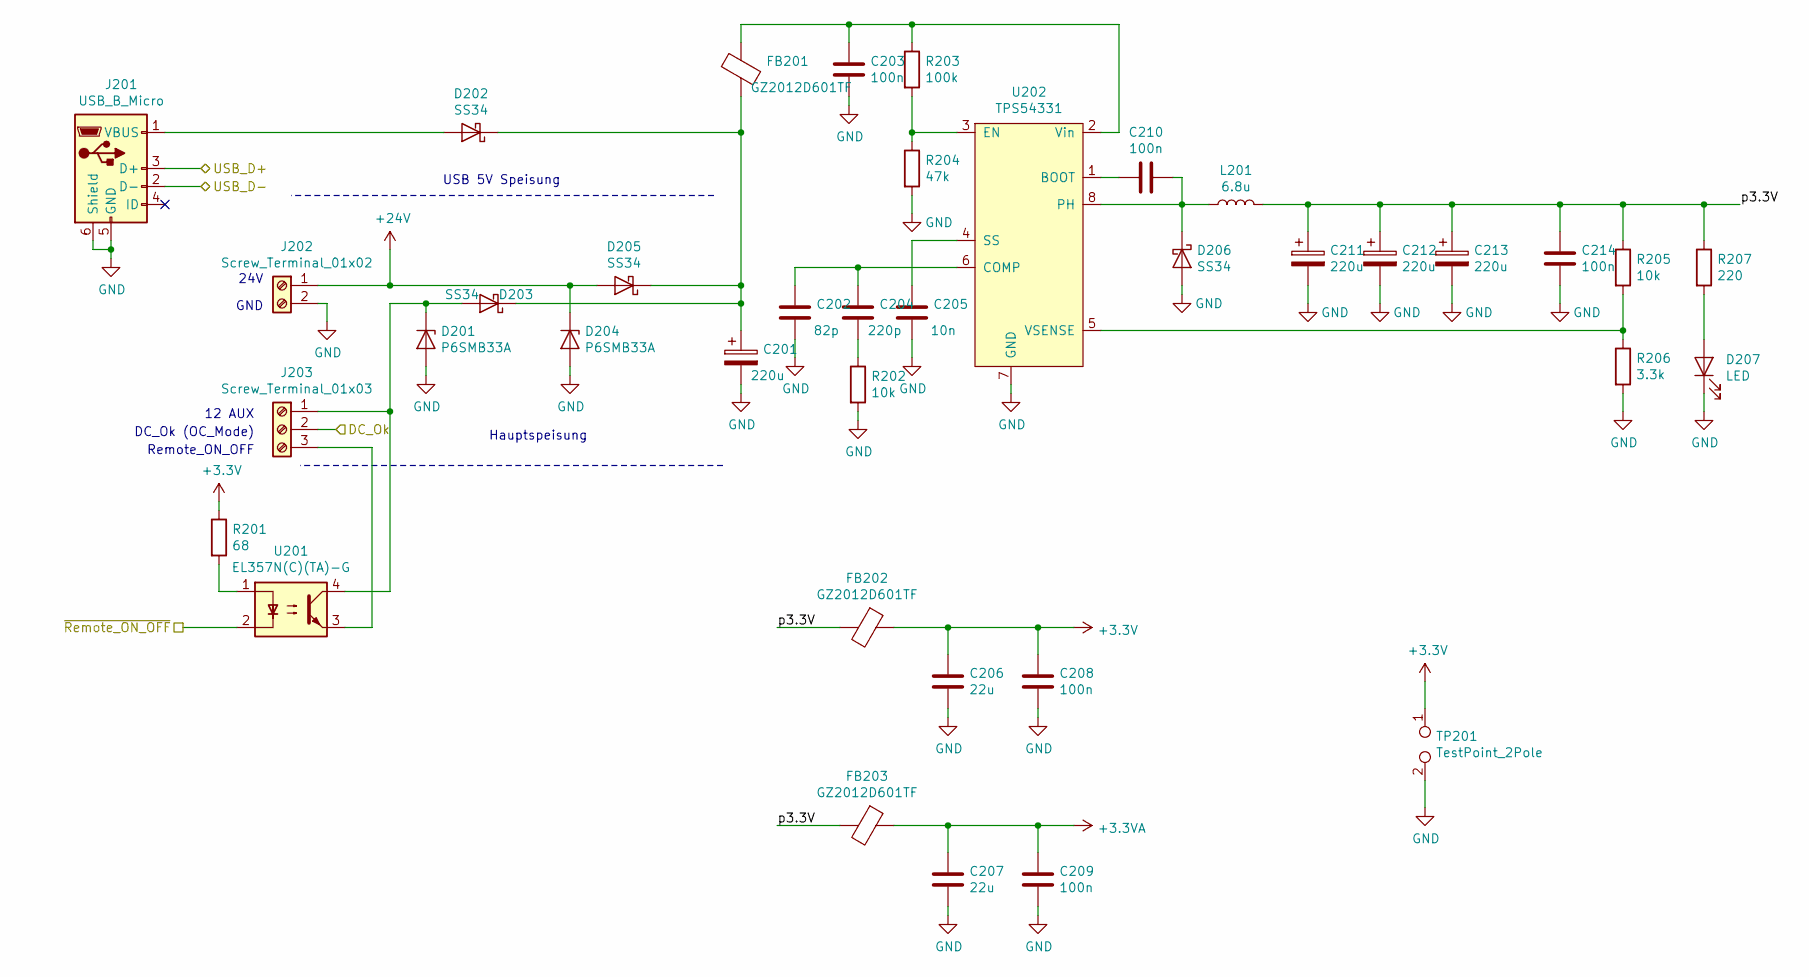
[picture p25: schematic powersupply_usb.sch]

Parts:
C201, C211, C212, C213: 220u; CP_Elec_8x10
C202: 82p; C_0603_1608Metric
C203, C210, C214: 100n; C_0603_1608Metric
C204: 220p; C_0603_1608Metric
C205: 10n; C_0603_1608Metric
C206, C207: 22u; C_0603_1608Metric
C208, C209: 100n; C_0402_1005Metric
D201, D204: P6SMB33A; D_SMB
D202, D203, D205, D206: SS34; D_SMA
D207: LED; LED_0603_1608Metric
FB201, FB202, FB203: GZ2012D601TF; C_0805_2012Metric
J201: USB_B_Micro; USB_Micro-B_Wuerth_629105150521_CircularHoles
J202: Screw_Terminal_01x02; 1756993
J203: Screw_Terminal_01x03; TerminalBlock_Phoenix_MPT-0,5-3-2.54_1x03_P2.54mm_Horizontal
L201: 6.8u; L_Sunlord_MWSA0518_5.4x5.2mm
R201: 68; R_0603_1608Metric
R202: 10k; R_0603_1608Metric
R203: 100k; R_0603_1608Metric
R204: 47k; R_0603_1608Metric
R205: 10k; R_0402_1005Metric
R206: 3.3k; R_0402_1005Metric
R207: 220; R_0603_1608Metric
TP201: TestPoint_2Pole; TestPoint_2Pads_Pitch5.08mm_Drill1.3mm
U201: EL357N(C)(TA)-G; SOP-4_3.8x4.1mm_P2.54mm
U202: TPS54331; SOIC-8_3.9x4.9mm_P1.27mm

Connections:
+3.3VA: C207.1, C209.1, FB203.1; also elsewhere on the board
+3V3: C206.1, C208.1, FB202.1, R201.1, TP201.1; also elsewhere on the board
+24V: D204.1 (K), D205.2 (A), J202.1; also elsewhere on the board
/64PinControllerversion/PWR_EN: U201.2; also elsewhere on the board
/64PinControllerversion/USB_D+: J201.3 (D+); also elsewhere on the board
/64PinControllerversion/USB_D-: J201.2 (D-); also elsewhere on the board
/Powersupply & USB/DC_Ok: J203.2; also elsewhere on the board
/Powersupply & USB/p3.3V: C211.1, C212.1, C213.1, C214.1, FB202.2, FB203.2, L201.2, R205.1, R207.1
GND: C201.2, C202.2, C203.2, C205.2, C206.2, C207.2, C208.2, C209.2, C211.2, C212.2, C213.2, C214.2, D201.2 (A), D204.2 (A), D206.2 (A), D207.1 (K), J201.5 (GND), J201.6 (Shield), J202.2, R202.2, R204.2, R206.2, TP201.2, U202.7 (GND); also elsewhere on the board
unnamed: C201.1, D202.1 (K), D203.1 (K), D205.1 (K), FB201.2
unnamed: C202.1, C204.1, U202.6 (COMP)
unnamed: C203.1, FB201.1, R203.1, U202.2 (Vin)
unnamed: C204.2, R202.1
unnamed: C205.1, U202.4 (SS)
unnamed: C210.1, D206.1 (K), L201.1, U202.8 (PH)
unnamed: C210.2, U202.1 (BOOT)
unnamed: D201.1 (K), D203.2 (A), J203.1, U201.4
unnamed: D202.2 (A), J201.1 (VBUS)
unnamed: D207.2 (A), R207.2
unnamed: J203.3, U201.3
unnamed: R201.2, U201.1
unnamed: R203.2, R204.1, U202.3 (EN)
unnamed: R205.2, R206.1, U202.5 (VSENSE)

Notes on the sheet:
USB 5V Speisung
Hauptspeisung
24V
12 AUX
DC_Ok (OC_Mode)
Remote_ON_OFF
GND

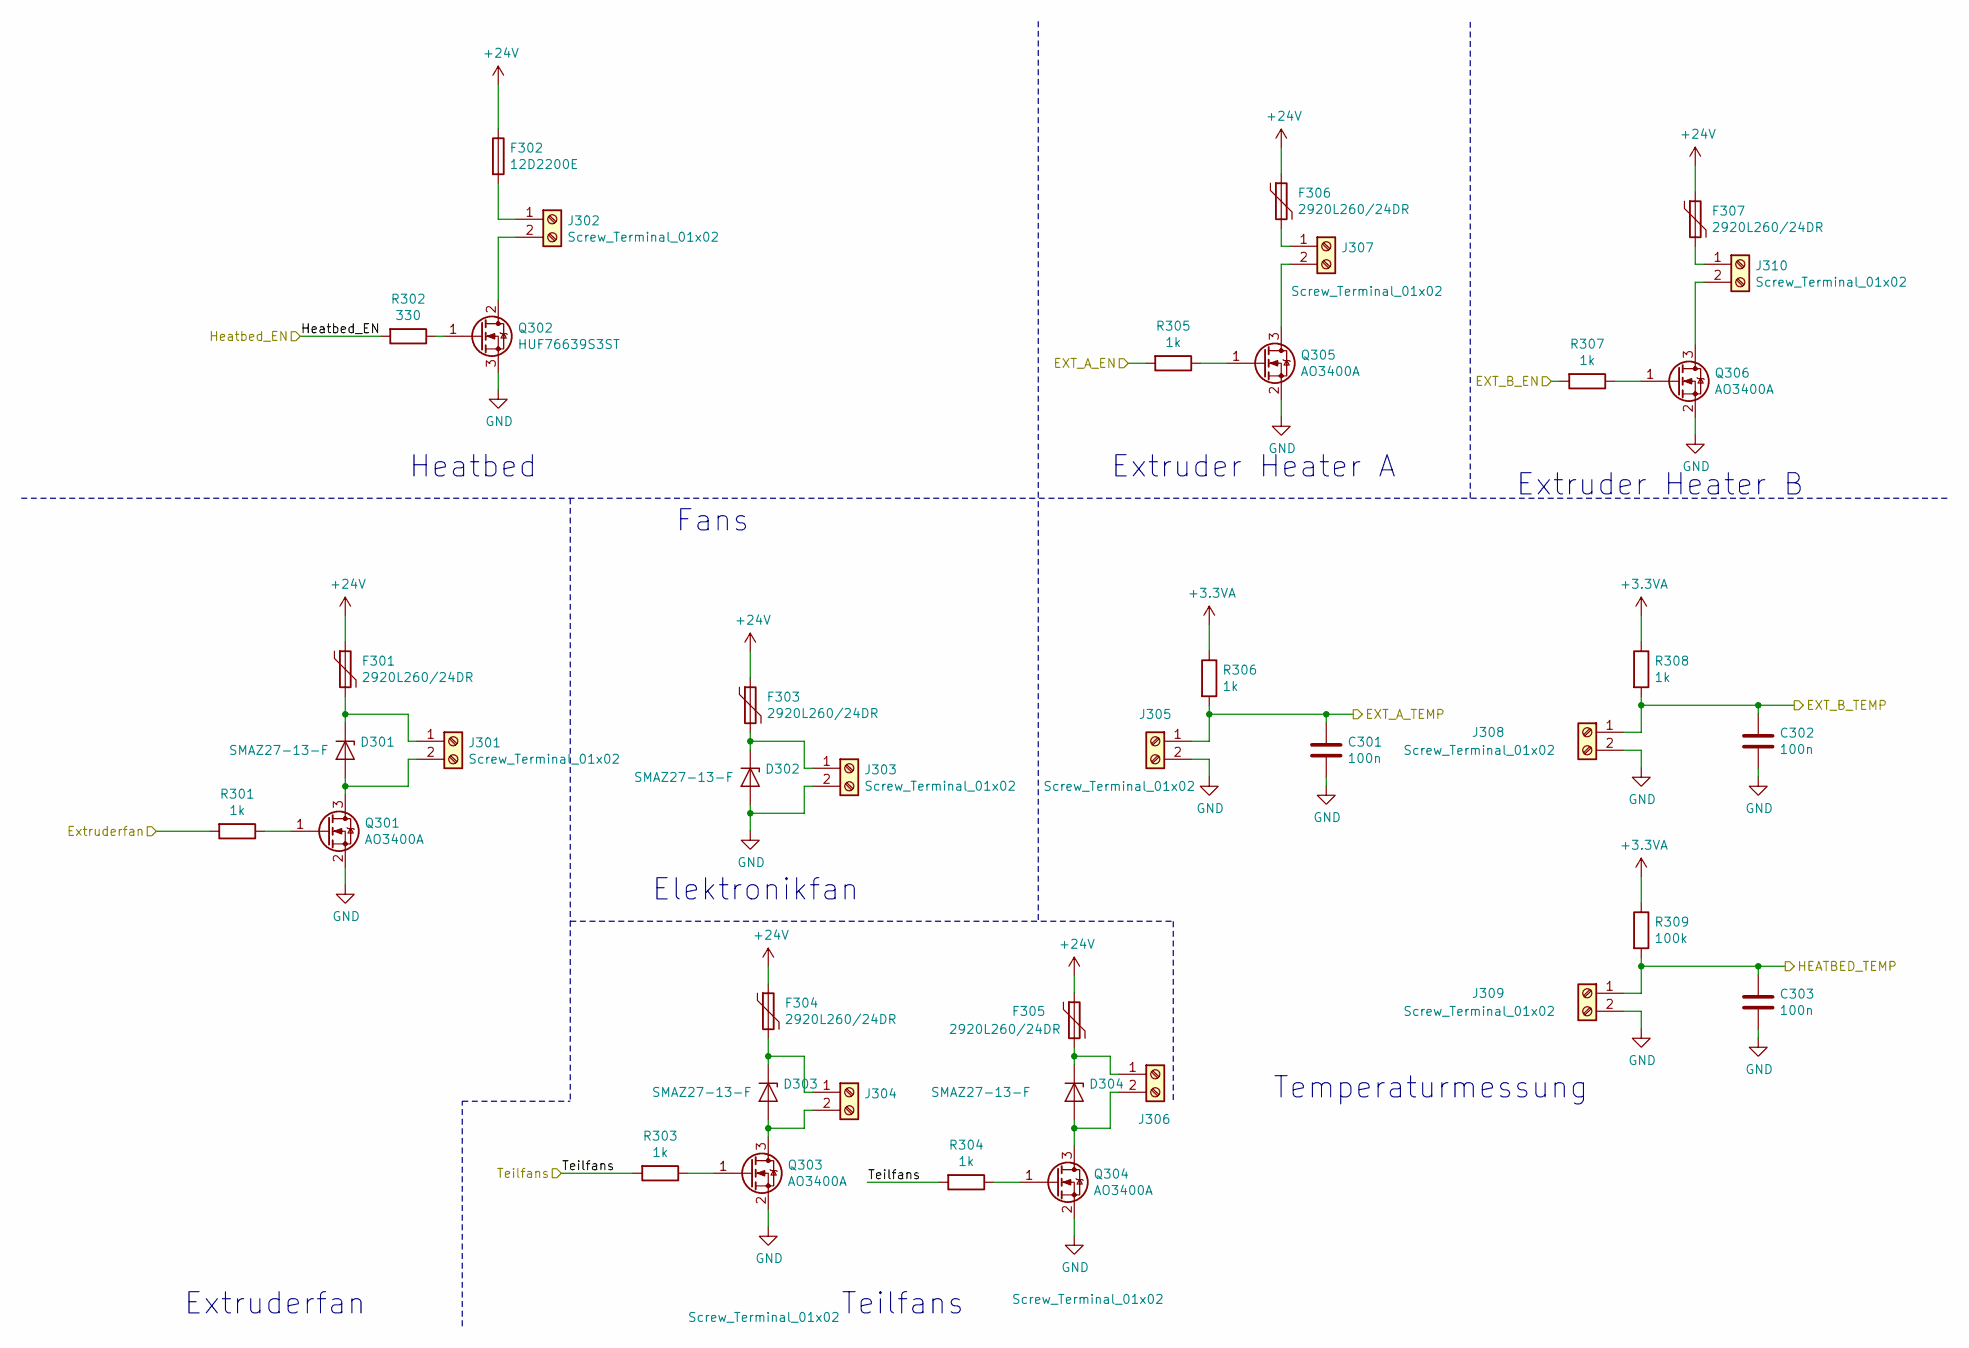
[picture p26: schematic Fan_Heater.sch]

Parts:
C301, C302, C303: 100n; C_0402_1005Metric
D301, D302, D303, D304: SMAZ27-13-F; D_SMA
F301, F303, F304, F305, F306, F307: 2920L260/24DR; Fuse_2920_7451Metric
F302: 12D2200E; Fuse_1206_3216Metric
J301, J303, J304, J305, J306, J307, J308, J309, J310: Screw_Terminal_01x02; TerminalBlock_Phoenix_MPT-0,5-2-2.54_1x02_P2.54mm_Horizontal
J302: Screw_Terminal_01x02; TerminalBlock_Phoenix_PT-1,5-2-3.5-H_1x02_P3.50mm_Horizontal
Q301, Q303, Q304, Q305, Q306: AO3400A; SOT-23
Q302: HUF76639S3ST; TO-263-2
R301, R303, R304, R305, R306, R307, R308: 1k; R_0402_1005Metric
R302: 330; R_0402_1005Metric
R309: 100k; R_0402_1005Metric

Connections:
+3.3VA: R306.1, R308.1, R309.1; also elsewhere on the board
+24V: F301.1, F302.1, F303.1, F304.1, F305.1, F306.1, F307.1; also elsewhere on the board
/64PinControllerversion/BED_TEMP: C303.1, J309.1, R309.2; also elsewhere on the board
/64PinControllerversion/E0_TEMP: C301.1, J305.1, R306.2; also elsewhere on the board
/64PinControllerversion/E1_TEMP: C302.1, J308.1, R308.2; also elsewhere on the board
/64PinControllerversion/FAN_TEIL: R303.2, R304.2; also elsewhere on the board
/Fans & Heater/EXT_A_EN: R305.2; also elsewhere on the board
/Fans & Heater/EXT_B_EN: R307.2; also elsewhere on the board
/Fans & Heater/Extruderfan: R301.2; also elsewhere on the board
/Fans & Heater/Heatbed_EN: R302.2; also elsewhere on the board
GND: C301.2, C302.2, C303.2, D302.2 (A), J303.2, J305.2, J308.2, J309.2, Q301.2 (S), Q302.3 (S), Q303.2 (S), Q304.2 (S), Q305.2 (S), Q306.2 (S); also elsewhere on the board
unnamed: D301.1 (K), F301.2, J301.1
unnamed: D301.2 (A), J301.2, Q301.3 (D)
unnamed: D302.1 (K), F303.2, J303.1
unnamed: D303.1 (K), F304.2, J304.1
unnamed: D303.2 (A), J304.2, Q303.3 (D)
unnamed: D304.1 (K), F305.2, J306.1
unnamed: D304.2 (A), J306.2, Q304.3 (D)
unnamed: F302.2, J302.1
unnamed: F306.2, J307.1
unnamed: F307.2, J310.1
unnamed: J302.2, Q302.2 (D)
unnamed: J307.2, Q305.3 (D)
unnamed: J310.2, Q306.3 (D)
unnamed: Q301.1 (G), R301.1
unnamed: Q302.1 (G), R302.1
unnamed: Q303.1 (G), R303.1
unnamed: Q304.1 (G), R304.1
unnamed: Q305.1 (G), R305.1
unnamed: Q306.1 (G), R307.1

Notes on the sheet:
Teilfans
Extruderfan
Elektronikfan
Extruder Heater A
Extruder Heater B
Temperaturmessung
Fans
Heatbed
