m47812/Custom-3D-Printer-Controller/3D_Printer_Mainboard_STM32/3D_Printer_Mainboard_STM32.kicad_pcb

## KiCad design 3D_Printer_Mainboard_STM32/3D_Printer_Mainboard_STM32.kicad_pcb (continued)

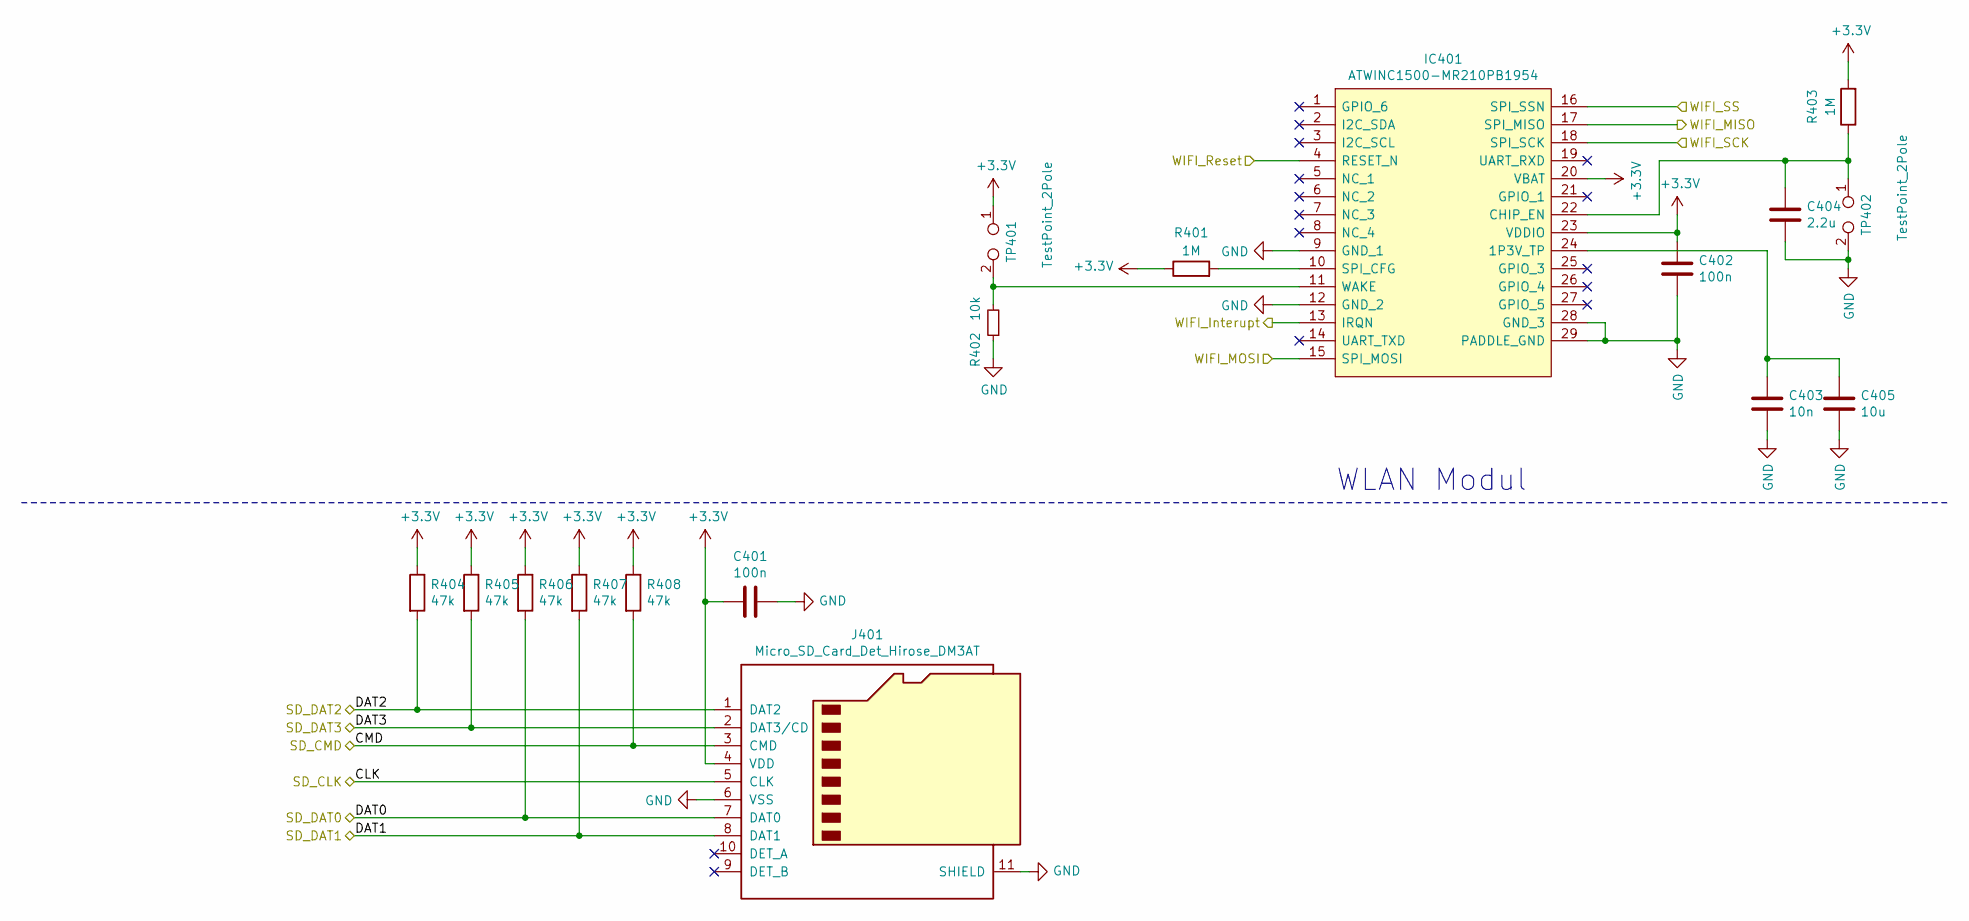
[picture p27: schematic WIFI_BT.sch]

Parts:
C401, C402: 100n; C_0402_1005Metric
C403: 10n; C_0402_1005Metric
C404: 2.2u; C_0603_1608Metric
C405: 10u; C_0402_1005Metric
IC401: ATWINC1500-MR210PB1954; ATWINC1500MR210UB1954; Mouser Part Number 579-1500MR210PB1954
J401: Micro_SD_Card_Det_Hirose_DM3AT; microSD_HC_Hirose_DM3D-SF
R401, R403: 1M; R_0402_1005Metric
R402: 10k; R_0402_1005Metric
R404, R405, R406, R407, R408: 47k; R_0402_1005Metric
TP401, TP402: TestPoint_2Pole; PinHeader_1x02_P2.54mm_Vertical

Connections:
+3V3: C401.2, C402.1, IC401.20 (VBAT), IC401.23 (VDDIO), J401.4 (VDD), R401.1, R403.2, R404.1, R405.1, R406.1, R407.1, R408.1, TP401.1; also elsewhere on the board
/64PinControllerversion/MUPI_MISO: IC401.17 (SPI_MISO); also elsewhere on the board
/64PinControllerversion/MUPI_MOSI: IC401.15 (SPI_MOSI); also elsewhere on the board
/64PinControllerversion/MUPI_SCK: IC401.18 (SPI_SCK); also elsewhere on the board
/64PinControllerversion/RESET: IC401.4 (RESET_N); also elsewhere on the board
/64PinControllerversion/SD_CLK: J401.5 (CLK); also elsewhere on the board
/64PinControllerversion/SD_CMD: J401.3 (CMD), R408.2; also elsewhere on the board
/64PinControllerversion/SD_DAT0: J401.7 (DAT0), R406.2; also elsewhere on the board
/64PinControllerversion/SD_DAT1: J401.8 (DAT1), R407.2; also elsewhere on the board
/64PinControllerversion/SD_DAT2: J401.1 (DAT2), R404.2; also elsewhere on the board
/64PinControllerversion/SD_DAT3: J401.2 (DAT3/CD), R405.2; also elsewhere on the board
/64PinControllerversion/WIFI_INTERRUPT: IC401.13 (IRQN); also elsewhere on the board
/64PinControllerversion/WIFI_SEL: IC401.16 (SPI_SSN); also elsewhere on the board
GND: C401.1, C402.2, C403.2, C404.2, C405.2, IC401.9 (GND_1), IC401.12 (GND_2), IC401.28 (GND_3), IC401.29 (PADDLE_GND), J401.6 (VSS), J401.11 (SHIELD), R402.1, TP402.2; also elsewhere on the board
unnamed: C403.1, C405.1, IC401.24 (1P3V_TP)
unnamed: C404.1, IC401.22 (CHIP_EN), R403.1, TP402.1
unnamed: IC401.10 (SPI_CFG), R401.2
unnamed: IC401.11 (WAKE), R402.2, TP401.2

Notes on the sheet:
WLAN Modul

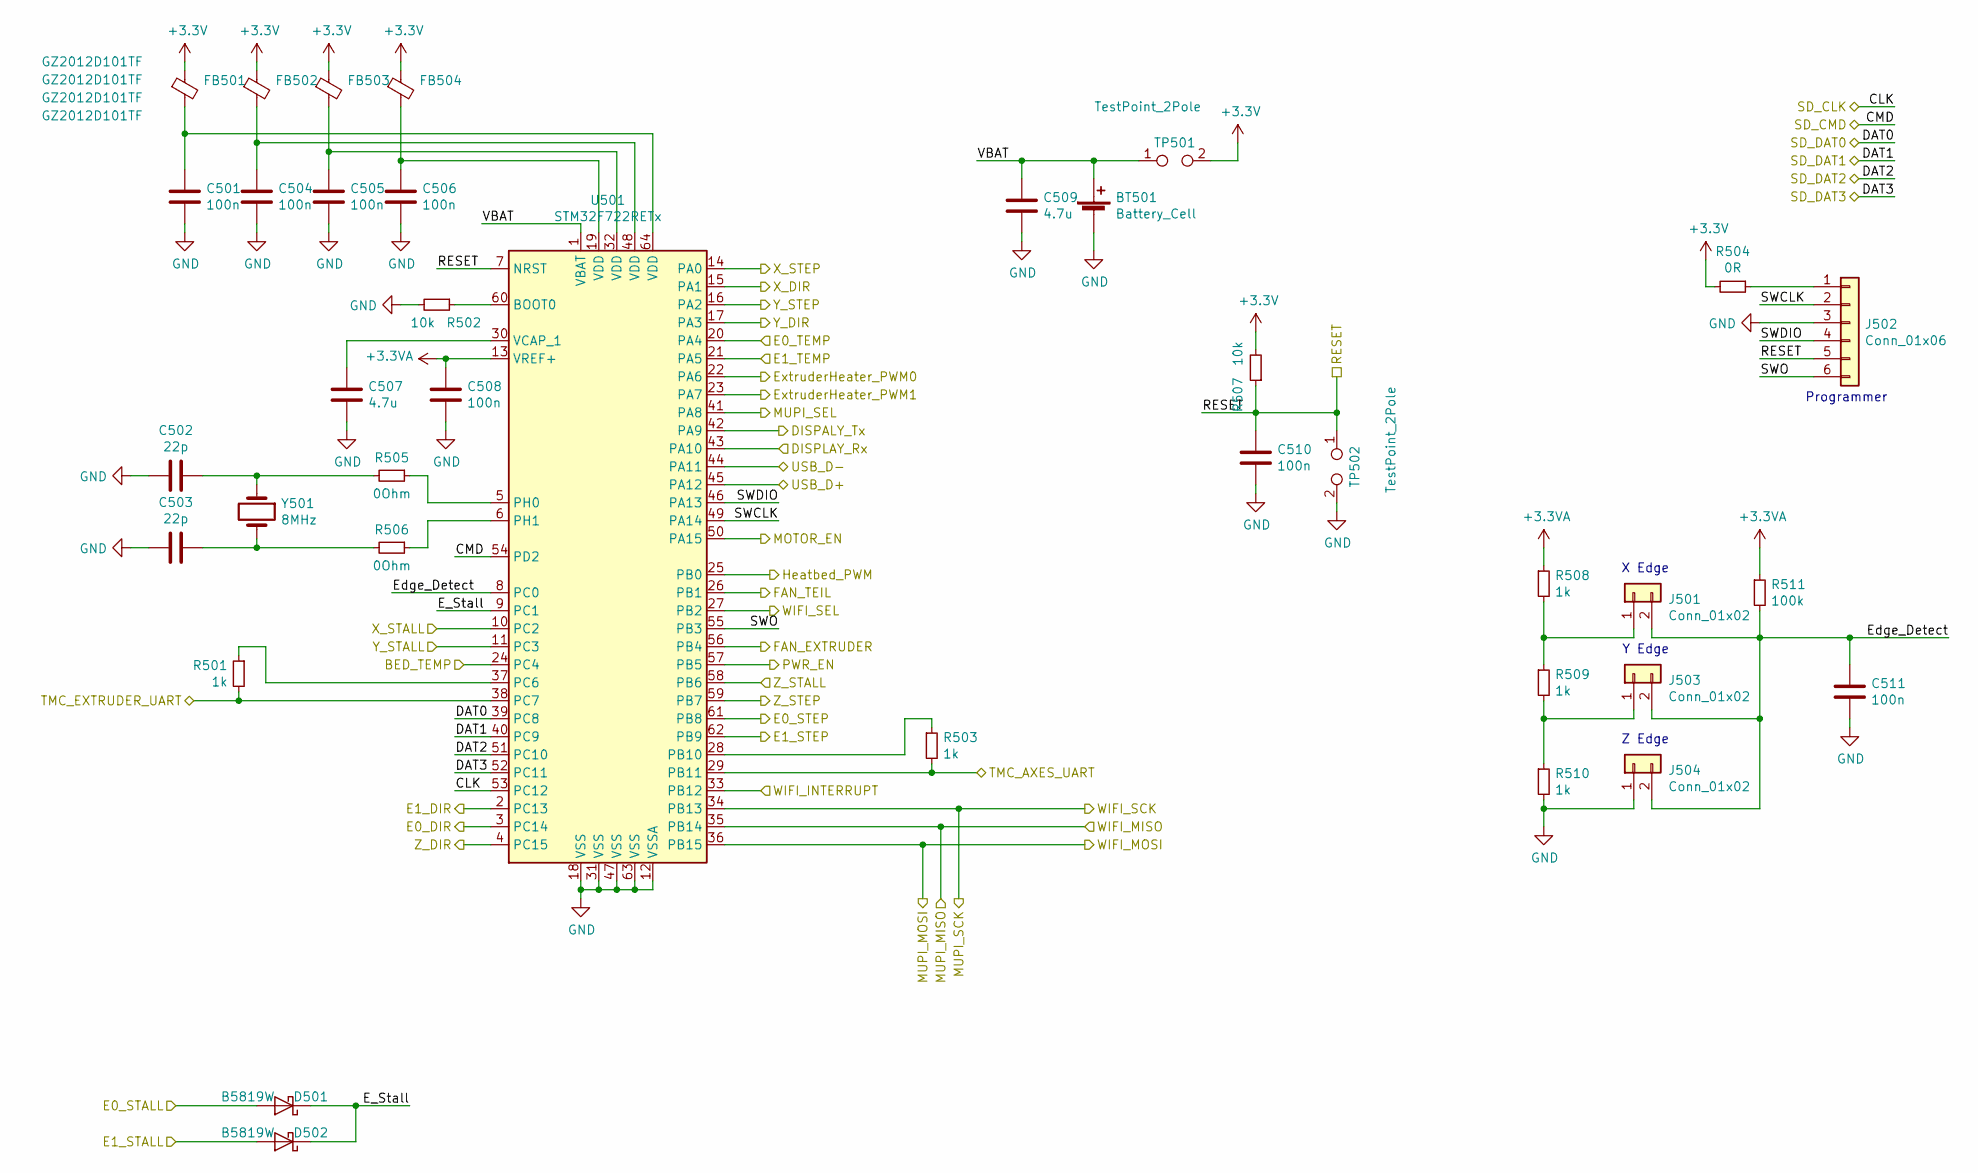
[picture p28: schematic Controller_64.sch]

Parts:
BT501: Battery_Cell; BatteryHolder_Keystone_1058_1x2032
C501, C504, C505, C506, C508, C510, C511: 100n; C_0402_1005Metric
C502, C503: 22p; C_0402_1005Metric
C507, C509: 4.7u; C_0603_1608Metric
D501, D502: B5819W; D_SOD-123
FB501, FB502, FB503, FB504: GZ2012D101TF; R_0805_2012Metric
J501, J503, J504: Conn_01x02; Molex_KK-254_AE-6410-02A_1x02_P2.54mm_Vertical
J502: Conn_01x06; PinHeader_1x06_P2.54mm_Vertical
R501, R503, R508, R509, R510: 1k; R_0402_1005Metric
R502, R507: 10k; R_0402_1005Metric
R504: 0R; R_0603_1608Metric_Pad1.05x0.95mm_HandSolder
R505, R506: 0Ohm; R_0603_1608Metric
R511: 100k; R_0402_1005Metric
TP501, TP502: TestPoint_2Pole; PinHeader_1x02_P2.54mm_Vertical
U501: STM32F722RETx; LQFP-64_10x10mm_P0.5mm
Y501: 8MHz; Crystal_SMD_5032-2Pin_5.0x3.2mm

Connections:
+3.3VA: C508.1, R508.1, R511.1, U501.13 (VREF+); also elsewhere on the board
+3V3: FB501.1, FB502.1, FB503.1, FB504.1, R504.2, R507.2, TP501.2; also elsewhere on the board
/64PinControllerversion/BED_TEMP: U501.24 (PC4); also elsewhere on the board
/64PinControllerversion/DISPALY_Tx: U501.42 (PA9); also elsewhere on the board
/64PinControllerversion/E0_DIR: U501.3 (PC14); also elsewhere on the board
/64PinControllerversion/E0_STEP: U501.61 (PB8); also elsewhere on the board
/64PinControllerversion/E0_TEMP: U501.20 (PA4); also elsewhere on the board
/64PinControllerversion/E1_DIR: U501.2 (PC13); also elsewhere on the board
/64PinControllerversion/E1_STEP: U501.62 (PB9); also elsewhere on the board
/64PinControllerversion/E1_TEMP: U501.21 (PA5); also elsewhere on the board
/64PinControllerversion/E_Stall: D501.1 (K), D502.1 (K), U501.9 (PC1)
/64PinControllerversion/Edge_Detect: C511.1, J501.2, J503.2, J504.2, R511.2, U501.8 (PC0)
/64PinControllerversion/FAN_TEIL: U501.26 (PB1); also elsewhere on the board
/64PinControllerversion/MOTOR_EN: U501.50 (PA15); also elsewhere on the board
/64PinControllerversion/MUPI_MISO: U501.35 (PB14); also elsewhere on the board
/64PinControllerversion/MUPI_MOSI: U501.36 (PB15); also elsewhere on the board
/64PinControllerversion/MUPI_SCK: U501.34 (PB13); also elsewhere on the board
/64PinControllerversion/MUPI_SEL: U501.41 (PA8); also elsewhere on the board
/64PinControllerversion/PWR_EN: U501.57 (PB5); also elsewhere on the board
/64PinControllerversion/RESET: C510.1, J502.5, R507.1, TP502.1, U501.7 (NRST); also elsewhere on the board
/64PinControllerversion/SD_CLK: U501.53 (PC12); also elsewhere on the board
/64PinControllerversion/SD_CMD: U501.54 (PD2); also elsewhere on the board
/64PinControllerversion/SD_DAT0: U501.39 (PC8); also elsewhere on the board
/64PinControllerversion/SD_DAT1: U501.40 (PC9); also elsewhere on the board
/64PinControllerversion/SD_DAT2: U501.51 (PC10); also elsewhere on the board
/64PinControllerversion/SD_DAT3: U501.52 (PC11); also elsewhere on the board
/64PinControllerversion/SWCLK: J502.2, U501.49 (PA14)
/64PinControllerversion/SWDIO: J502.4, U501.46 (PA13)
/64PinControllerversion/SWO: J502.6, U501.55 (PB3)
/64PinControllerversion/TMC_AXES_UART: R503.2, U501.29 (PB11); also elsewhere on the board
/64PinControllerversion/TMC_EXTRUDER_UART: R501.2, U501.38 (PC7); also elsewhere on the board
/64PinControllerversion/USB_D+: U501.45 (PA12); also elsewhere on the board
/64PinControllerversion/USB_D-: U501.44 (PA11); also elsewhere on the board
/64PinControllerversion/VBAT: BT501.1 (+), C509.1, TP501.1, U501.1 (VBAT)
/64PinControllerversion/WIFI_INTERRUPT: U501.33 (PB12); also elsewhere on the board
/64PinControllerversion/WIFI_SEL: U501.27 (PB2); also elsewhere on the board
/64PinControllerversion/X_DIR: U501.15 (PA1); also elsewhere on the board
/64PinControllerversion/X_STEP: U501.14 (PA0); also elsewhere on the board
/64PinControllerversion/Y_DIR: U501.17 (PA3); also elsewhere on the board
/64PinControllerversion/Y_STEP: U501.16 (PA2); also elsewhere on the board
/64PinControllerversion/Z_DIR: U501.4 (PC15); also elsewhere on the board
/64PinControllerversion/Z_STEP: U501.59 (PB7); also elsewhere on the board
/Fans & Heater/EXT_A_EN: U501.22 (PA6); also elsewhere on the board
/Fans & Heater/EXT_B_EN: U501.23 (PA7); also elsewhere on the board
/Fans & Heater/Extruderfan: U501.56 (PB4); also elsewhere on the board
/Fans & Heater/Heatbed_EN: U501.25 (PB0); also elsewhere on the board
/MUPI Connector & Display/DISPLAY_IN_RX: U501.43 (PA10); also elsewhere on the board
/Stepperdrivers/E0_DRIVER_STALL: D501.2 (A); also elsewhere on the board
/Stepperdrivers/E1_DRIVER_STALL: D502.2 (A); also elsewhere on the board
/Stepperdrivers/X_DRIVER_STALL: U501.10 (PC2); also elsewhere on the board
/Stepperdrivers/Y_DRIVER_STALL: U501.11 (PC3); also elsewhere on the board
/Stepperdrivers/Z_DRIVER_STALL: U501.58 (PB6); also elsewhere on the board
GND: BT501.2 (-), C501.1, C502.2, C503.2, C504.1, C505.1, C506.1, C507.2, C508.2, C509.2, C510.2, C511.2, J502.3, J504.1, R502.2, R510.2, TP502.2, U501.12 (VSSA), U501.18 (VSS), U501.31 (VSS), U501.47 (VSS), U501.63 (VSS); also elsewhere on the board
unnamed: C501.2, FB501.2, U501.64 (VDD)
unnamed: C502.1, R505.2, Y501.1
unnamed: C503.1, R506.2, Y501.2
unnamed: C504.2, FB502.2, U501.48 (VDD)
unnamed: C505.2, FB503.2, U501.32 (VDD)
unnamed: C506.2, FB504.2, U501.19 (VDD)
unnamed: C507.1, U501.30 (VCAP_1)
unnamed: J501.1, R508.2, R509.1
unnamed: J502.1, R504.1
unnamed: J503.1, R509.2, R510.1
unnamed: R501.1, U501.37 (PC6)
unnamed: R502.1, U501.60 (BOOT0)
unnamed: R503.1, U501.28 (PB10)
unnamed: R505.1, U501.5 (PH0)
unnamed: R506.1, U501.6 (PH1)

Notes on the sheet:
Programmer
X Edge
Y Edge
Z Edge

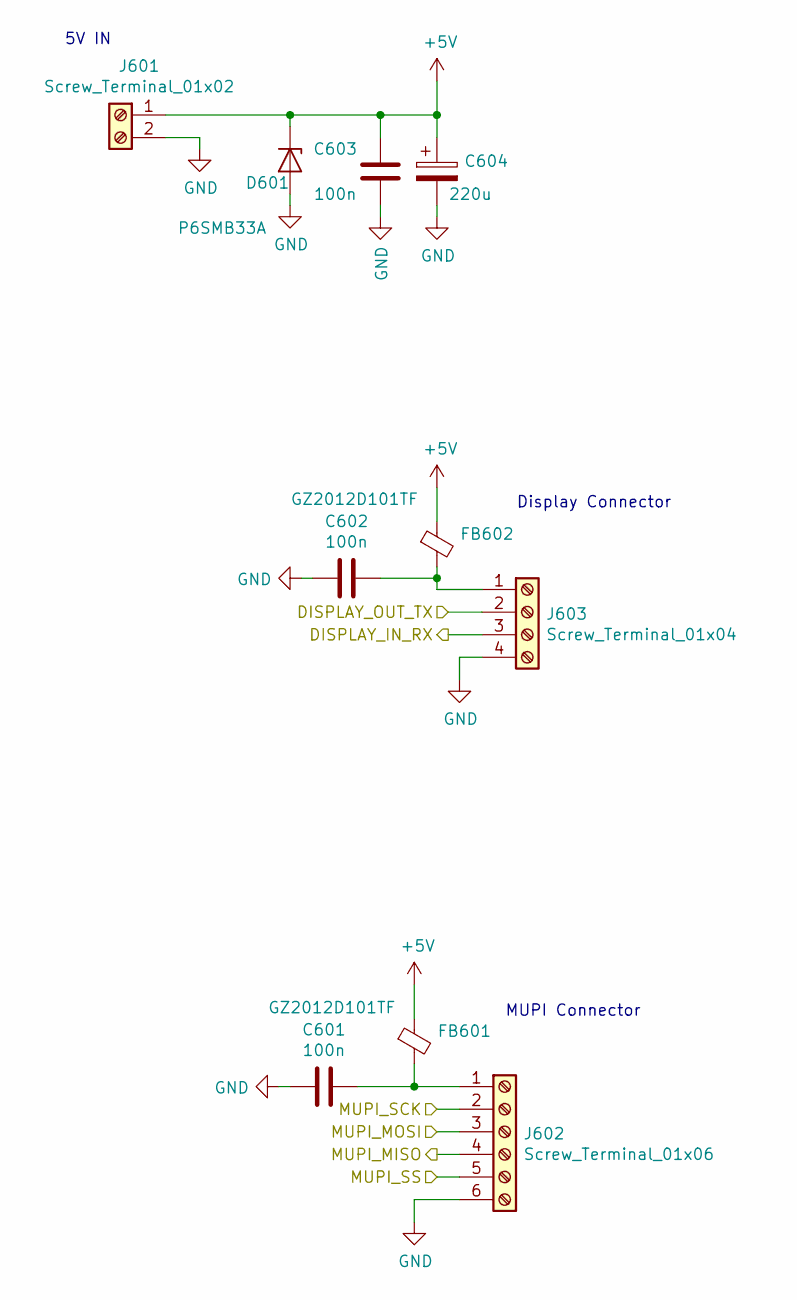
[picture p29: schematic MUPIConnector.sch]

Parts:
C601, C602, C603: 100n; C_0603_1608Metric
C604: 220u; CP_Elec_8x10
D601: P6SMB33A; D_SMB
FB601, FB602: GZ2012D101TF; R_0805_2012Metric
J601: Screw_Terminal_01x02; TerminalBlock_Phoenix_MPT-0,5-2-2.54_1x02_P2.54mm_Horizontal
J602: Screw_Terminal_01x06; TerminalBlock_Phoenix_MPT-0,5-6-2.54_1x06_P2.54mm_Horizontal
J603: Screw_Terminal_01x04; TerminalBlock_Phoenix_MPT-0,5-4-2.54_1x04_P2.54mm_Horizontal

Connections:
+5V: C603.1, C604.1, D601.1 (K), FB601.1, FB602.1, J601.1
/64PinControllerversion/DISPALY_Tx: J603.2; also elsewhere on the board
/64PinControllerversion/MUPI_MISO: J602.4; also elsewhere on the board
/64PinControllerversion/MUPI_MOSI: J602.3; also elsewhere on the board
/64PinControllerversion/MUPI_SCK: J602.2; also elsewhere on the board
/64PinControllerversion/MUPI_SEL: J602.5; also elsewhere on the board
/MUPI Connector & Display/DISPLAY_IN_RX: J603.3; also elsewhere on the board
GND: C601.2, C602.2, C603.2, C604.2, D601.2 (A), J601.2, J602.6, J603.4; also elsewhere on the board
unnamed: C601.1, FB601.2, J602.1
unnamed: C602.1, FB602.2, J603.1

Notes on the sheet:
MUPI Connector
Display Connector
5V IN

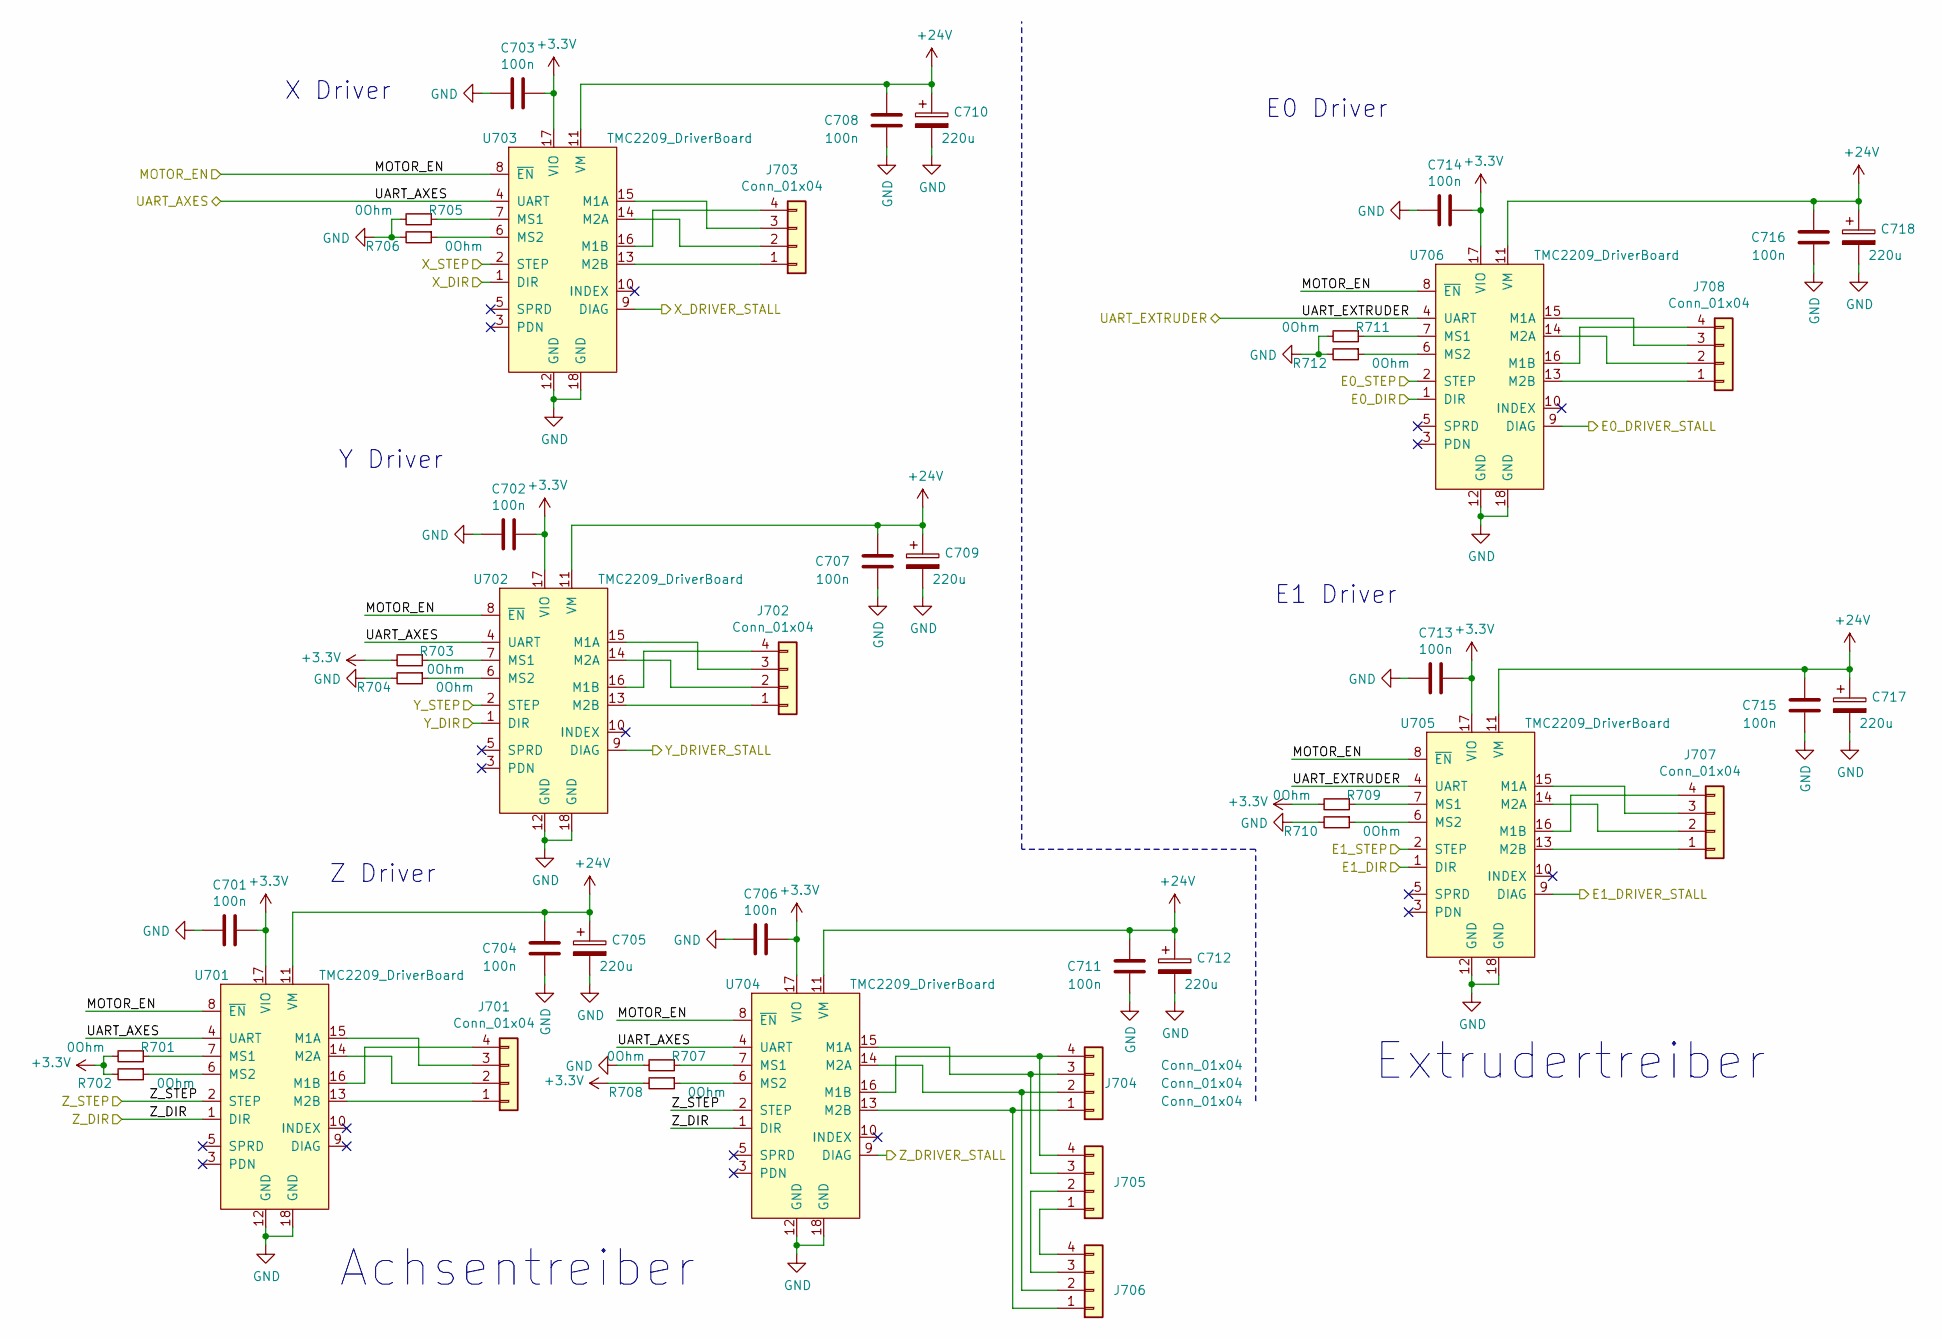
[picture p30: schematic Steppers.sch]

Parts:
C701, C702, C703, C704, C706, C707, C708, C711, C713, C714, C715, C716: 100n; C_0603_1608Metric
C705, C709, C710, C712, C717, C718: 220u; CP_Elec_8x10
J701, J702, J703, J704, J705, J706, J707, J708: Conn_01x04; Molex_KK-254_AE-6410-04A_1x04_P2.54mm_Vertical
R701, R702, R703, R704, R705, R706, R707, R708, R709, R710, R711, R712: 0Ohm; R_0603_1608Metric
U701, U702, U703, U704, U705, U706: TMC2209_DriverBoard

Connections:
+3V3: C701.1, C702.1, C703.1, C706.1, C713.1, C714.1, R701.2, R702.2, R703.2, R708.2, R709.2, U701.17 (VIO), U702.17 (VIO), U703.17 (VIO), U704.17 (VIO), U705.17 (VIO), U706.17 (VIO); also elsewhere on the board
+24V: C704.1, C705.1, C707.1, C708.1, C709.1, C710.1, C711.1, C712.1, C715.1, C716.1, C717.1, C718.1, U701.11 (VM), U702.11 (VM), U703.11 (VM), U704.11 (VM), U705.11 (VM), U706.11 (VM); also elsewhere on the board
/64PinControllerversion/E0_DIR: U706.1 (DIR); also elsewhere on the board
/64PinControllerversion/E0_STEP: U706.2 (STEP); also elsewhere on the board
/64PinControllerversion/E1_DIR: U705.1 (DIR); also elsewhere on the board
/64PinControllerversion/E1_STEP: U705.2 (STEP); also elsewhere on the board
/64PinControllerversion/MOTOR_EN: U701.8 (~EN), U702.8 (~EN), U703.8 (~EN), U704.8 (~EN), U705.8 (~EN), U706.8 (~EN); also elsewhere on the board
/64PinControllerversion/TMC_AXES_UART: U701.4 (UART), U702.4 (UART), U703.4 (UART), U704.4 (UART); also elsewhere on the board
/64PinControllerversion/TMC_EXTRUDER_UART: U705.4 (UART), U706.4 (UART); also elsewhere on the board
/64PinControllerversion/X_DIR: U703.1 (DIR); also elsewhere on the board
/64PinControllerversion/X_STEP: U703.2 (STEP); also elsewhere on the board
/64PinControllerversion/Y_DIR: U702.1 (DIR); also elsewhere on the board
/64PinControllerversion/Y_STEP: U702.2 (STEP); also elsewhere on the board
/64PinControllerversion/Z_DIR: U701.1 (DIR), U704.1 (DIR); also elsewhere on the board
/64PinControllerversion/Z_STEP: U701.2 (STEP), U704.2 (STEP); also elsewhere on the board
/Stepperdrivers/E0_DRIVER_STALL: U706.9 (DIAG); also elsewhere on the board
/Stepperdrivers/E1_DRIVER_STALL: U705.9 (DIAG); also elsewhere on the board
/Stepperdrivers/X_DRIVER_STALL: U703.9 (DIAG); also elsewhere on the board
/Stepperdrivers/Y_DRIVER_STALL: U702.9 (DIAG); also elsewhere on the board
/Stepperdrivers/Z_DRIVER_STALL: U704.9 (DIAG); also elsewhere on the board
GND: C701.2, C702.2, C703.2, C704.2, C705.2, C706.2, C707.2, C708.2, C709.2, C710.2, C711.2, C712.2, C713.2, C714.2, C715.2, C716.2, C717.2, C718.2, R704.2, R705.2, R706.2, R707.2, R710.2, R711.2, R712.2, U701.12 (GND), U701.18 (GND), U702.12 (GND), U702.18 (GND), U703.12 (GND), U703.18 (GND), U704.12 (GND), U704.18 (GND), U705.12 (GND), U705.18 (GND), U706.12 (GND), U706.18 (GND); also elsewhere on the board
unnamed: J701.1, U701.13 (M2B)
unnamed: J701.2, U701.14 (M2A)
unnamed: J701.3, U701.15 (M1A)
unnamed: J701.4, U701.16 (M1B)
unnamed: J702.1, U702.13 (M2B)
unnamed: J702.2, U702.14 (M2A)
unnamed: J702.3, U702.15 (M1A)
unnamed: J702.4, U702.16 (M1B)
unnamed: J703.1, U703.13 (M2B)
unnamed: J703.2, U703.14 (M2A)
unnamed: J703.3, U703.15 (M1A)
unnamed: J703.4, U703.16 (M1B)
unnamed: J704.1, J706.1, U704.13 (M2B)
unnamed: J704.2, J706.2, U704.14 (M2A)
unnamed: J704.3, J705.3, U704.15 (M1A)
unnamed: J704.4, J705.4, U704.16 (M1B)
unnamed: J705.1, J706.4
unnamed: J705.2, J706.3
unnamed: J707.1, U705.13 (M2B)
unnamed: J707.2, U705.14 (M2A)
unnamed: J707.3, U705.15 (M1A)
unnamed: J707.4, U705.16 (M1B)
unnamed: J708.1, U706.13 (M2B)
unnamed: J708.2, U706.14 (M2A)
unnamed: J708.3, U706.15 (M1A)
unnamed: J708.4, U706.16 (M1B)
unnamed: R701.1, U701.7 (MS1)
unnamed: R702.1, U701.6 (MS2)
unnamed: R703.1, U702.7 (MS1)
unnamed: R704.1, U702.6 (MS2)
unnamed: R705.1, U703.7 (MS1)
unnamed: R706.1, U703.6 (MS2)
unnamed: R707.1, U704.7 (MS1)
unnamed: R708.1, U704.6 (MS2)
unnamed: R709.1, U705.7 (MS1)
unnamed: R710.1, U705.6 (MS2)
unnamed: R711.1, U706.7 (MS1)
unnamed: R712.1, U706.6 (MS2)

Notes on the sheet:
Achsentreiber
Extrudertreiber
X Driver
Y Driver
E0 Driver
E1 Driver
Z Driver

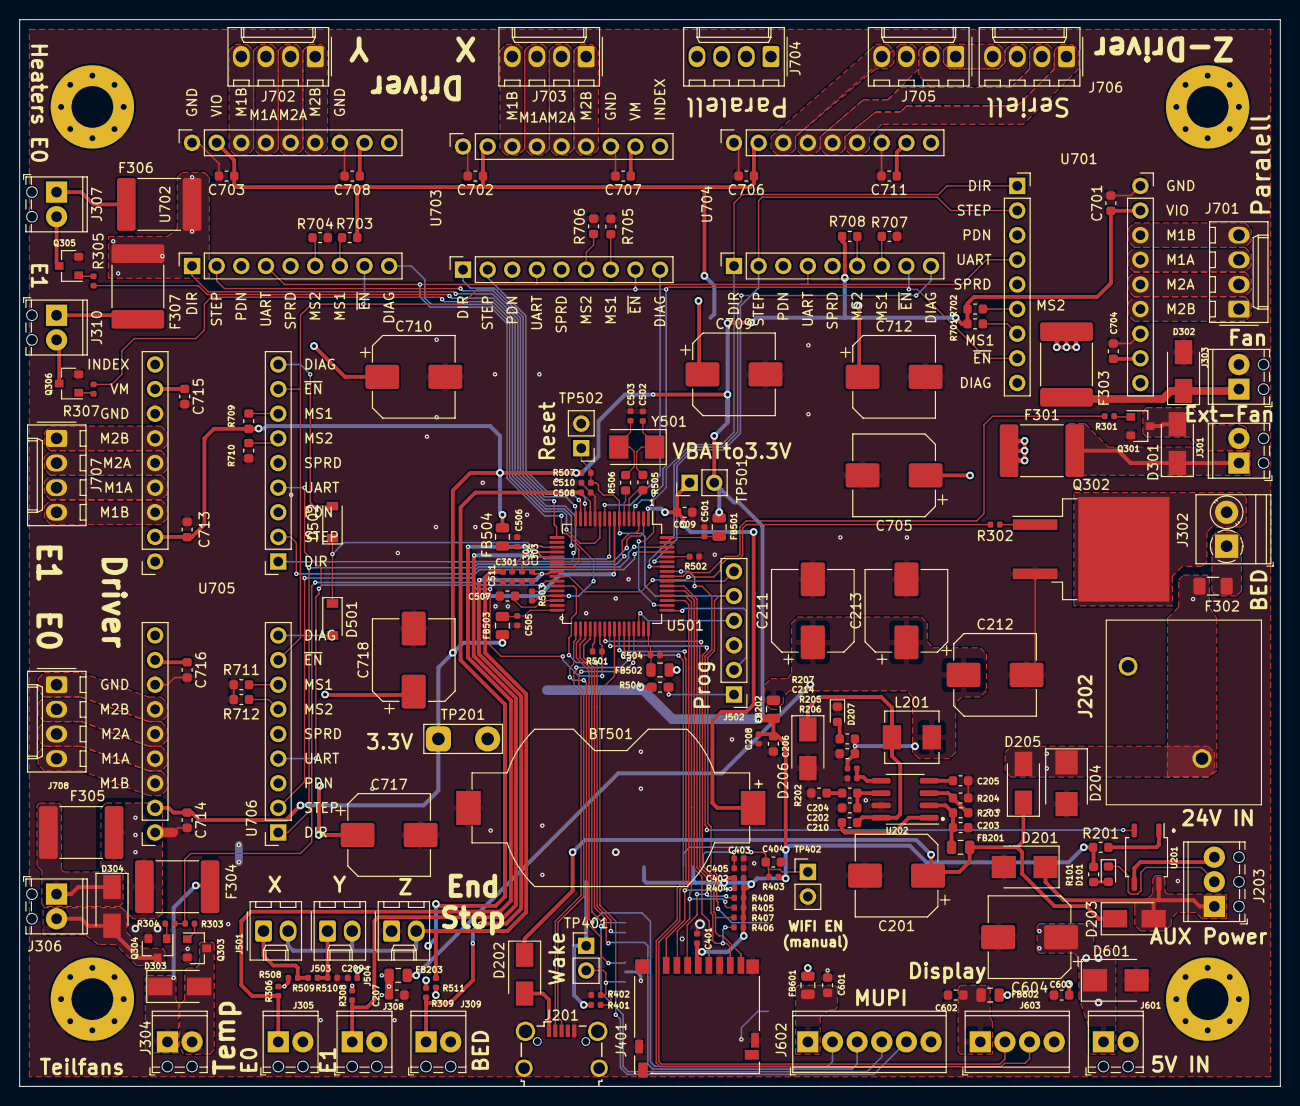
[picture p31: board 3D_Printer_Mainboard_STM32.kicad_pcb from above]

Board: 2 copper layers, 130.0 x 110.0 mm, 191 parts (1 on the bottom side), 150 nets.
