m47812/Custom-3D-Printer-Controller/(commit log)

2022-04-30 Added Mainboard Files
    [3D_Printer_Mainboard_STM32-B_Cu.gbr, 3D_Printer_Mainboard_STM32-B_Mask.gbr, 3D_Printer_Mainboard_STM32-B_Paste.gbr, 3D_Printer_Mainboard_STM32-B_SilkS.gbr, 3D_Printer_Mainboard_STM32-Edge_Cuts.gbr, 3D_Printer_Mainboard_STM32-F_Cu.gbr, 3D_Printer_Mainboard_STM32-F_Mask.gbr, 3D_Printer_Mainboard_STM32-F_Paste.gbr]
2022-04-30 Motor Driver
    [3D_Printer_Stepper_TMC2209-B_Cu.gbr, 3D_Printer_Stepper_TMC2209-B_Mask.gbr, 3D_Printer_Stepper_TMC2209-B_Paste.gbr, 3D_Printer_Stepper_TMC2209-B_SilkS.gbr, 3D_Printer_Stepper_TMC2209-Edge_Cuts.gbr, 3D_Printer_Stepper_TMC2209-F_Cu.gbr, 3D_Printer_Stepper_TMC2209-F_Mask.gbr, 3D_Printer_Stepper_TMC2209-F_Paste.gbr]
2022-04-30 Added Handheld files
    [LEDs.sch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]
2022-04-30 Components List
    [Komponenten_V2.xlsx]
