m47812/Custom-3D-Printer-Controller/(notices)

Notices in the files:
README.md:
License: GPL
